Felipe-klz/cr200-explorador/downloads/presupuesto.md

# CR200 · BOM y presupuesto de planificación

Argentina,AMBA. Precios consultados24/10/2026. Revisión geométricaS02-A62bc86d8.

Base con auxilio,desarrollo y contingencia20%:ARS 25.659.730. Escenario bajo:ARS 21.227.311;alto:ARS 38.456.928. No es oferta firme ni autorización de fabricación.

## Detalle

|Código|Concepto|Cantidad|Unitario origen|Subtotal ARS de línea|Estado|
|---|---|---:|---:|---:|---|
|M01|Largueros RHS150×75×5|2 barra 6m|ARS 405,060.00|ARS 810.120|Estimado · a cotizar|
|M02|Travesaños RHS80×40×3|4 barra 6m|ARS 103,599.00|ARS 414.396|Estimado · a cotizar|
|M03|Brazos de lanza RHS150×60×5|1 barra 6m|ARS 376,800.00|ARS 376.800|Estimado · a cotizar|
|M04|Arriostramiento RHS60×40×3|1 barra 6m|ARS 85,000.00|ARS 85.000|Estimado · a cotizar|
|M05|Reacción de estacionamiento RHS40×40×3|1 barra 6m|ARS 65,000.00|ARS 65.000|Estimado · a cotizar|
|M06|Travesaño posterior RHS80×60×3|1 barra 6m|ARS 106,450.50|ARS 106.450|Estimado · a cotizar|
|M07|Chapas mixtas e4/5/6/8/10 · soportes y puentes|123 kg bruto|ARS 3,200.00|ARS 393.600|Estimado · a cotizar|
|M08|Galvanizada2 mm · guardabarros y faldones|1 chapa 1.22×2.44m|ARS 171,026.00|ARS 171.026|Publicado · confirmar anidado|
|M09|Ejes frenados completos · referencia local1000 kg|2 eje|ARS 1,290,000.00|ARS 2.580.000|Publicado · configuración distinta|
|M10|Configuración a medida y verificación de interfaces|1 previsión|ARS 320,000.00|ARS 320.000|Estimado · a cotizar|
|M11|NeumáticoST205/75R15 107N D|4 unidad|USD 186.00|ARS 1.153.200|Publicado · origen exterior|
|M12|Llantas15×5.5,5×114.3 con capacidad certificada|4 unidad|ARS 150,000.00|ARS 600.000|Estimado · a cotizar|
|M13|Paquetes completos doble ojo,1250 lb de referencia|4 paquete|USD 34.18|ARS 211.916|Publicado · referencia compatible a verificar|
|M14|Articulación tándem completa · húmedos y bronce|1 kit|USD 160.00|ARS 248.000|Estimado · a cotizar|
|M15|AbrazaderasU y tuercas/arandelas|8 juegoU+2tuercas|ARS 18,000.00|ARS 144.000|Estimado · a cotizar|
|M16|Asientos de ballesta mecanizados|4 unidad|ARS 20,000.00|ARS 80.000|Estimado · a cotizar|
|M17|Amortiguador283271 con herrajes de espárrago|4 conjunto|USD 65.95|ARS 408.890|Publicado · origen exterior|
|M18|Topes elastoméricos de compresión|4 unidad|ARS 18,000.00|ARS 72.000|Estimado · a cotizar|
|M19|Cabezal50 mm con pestillo y palanca ·614010PL|1 conjunto|AUD 129.00|ARS 138.962|Publicado · interfaz pendiente|
|M20|Cadenas certificadas con grilletes/ganchos|2 conjunto|ARS 65,000.00|ARS 130.000|Estimado · a cotizar|
|M21|Jockey con rueda y abrazadera|1 conjunto|ARS 143,076.00|ARS 143.076|Publicado · montaje a confirmar|
|M22|Estabilizadores de esquina|4 unidad|ARS 164,904.00|ARS 659.616|Publicado · modelo de referencia|
|M23|Fijación de cabezalM12 8.8|4 juego|ARS 5,000.00|ARS 20.000|Estimado · a cotizar|
|M24|Anclajes viviendaM10 con casquillo y contraplaca|10 conjunto|ARS 12,000.00|ARS 120.000|Estimado · a cotizar|
|M25|Estacionamiento: fundas, cables y repartidor|1 kit 4 ruedas|ARS 225,000.00|ARS 225.000|Estimado · a cotizar|
|M26|Controlador de frenos · referencia económica|1 unidad|ARS 420,000.00|ARS 420.000|Publicado · confirmar inclusión|
|M27|Ruptura eléctrica: interruptor, batería y caja|1 kit|ARS 180,000.00|ARS 180.000|Estimado · a cotizar|
|M28|Ópticas traseras LED con reversa|1 par|ARS 37,100.00|ARS 37.100|Publicado · especificación a verificar|
|M29|Marcadores laterales ámbar|6 unidad|ARS 15,000.00|ARS 90.000|Estimado · a cotizar|
|M30|Catadióptricos triangulares rojos|2 unidad|ARS 6,500.00|ARS 13.000|Estimado · a cotizar|
|M31|Portapatente e iluminación blanca|1 conjunto|ARS 30,000.00|ARS 30.000|Estimado · a cotizar|
|M32|Mazo, conectores y protecciones|1 lote|ARS 220,000.00|ARS 220.000|Estimado · a cotizar|
|M33|Presillas aisladas con fijación|11 juego|ARS 3,000.00|ARS 33.000|Estimado · a cotizar|
|M34|Cajas de derivación estancas de frenos|2 unidad|ARS 15,000.00|ARS 30.000|Estimado · a cotizar|
|M35|Tornillería auxiliar no desglosada|1 lote|ARS 85,000.00|ARS 85.000|Estimado · a cotizar|
|C01|AlambreMIG ER70S6|2 rollo 5 kg|ARS 29,267.00|ARS 58.534|Publicado · consumo estimado|
|C02|Gas, abrasivos y consumibles de taller|1 lote|ARS 150,000.00|ARS 150.000|Estimado · a cotizar|
|S01|Plantilla, trazado y preparación|12 hora|ARS 18,000.00|ARS 216.000|Estimado · a cotizar|
|S02|Corte de tubos y perforado|24 hora|ARS 18,000.00|ARS 432.000|Estimado · a cotizar|
|S03|Armado, punteo y soldadura|56 hora|ARS 18,000.00|ARS 1.008.000|Estimado · a cotizar|
|S04|Montaje mecánico de conjuntos|24 hora|ARS 18,000.00|ARS 432.000|Estimado · a cotizar|
|S05|Instalación eléctrica|14 hora|ARS 18,000.00|ARS 252.000|Estimado · a cotizar|
|S06|Reglaje frenos y estacionamiento|12 hora|ARS 18,000.00|ARS 216.000|Estimado · a cotizar|
|S07|Control dimensional y terminación|12 hora|ARS 18,000.00|ARS 216.000|Estimado · a cotizar|
|S08|Corte láser de chapas y preparación|1 lote|ARS 280,000.00|ARS 280.000|Estimado · a cotizar|
|S09|Plegado de puentes y guardabarros|1 lote|ARS 180,000.00|ARS 180.000|Estimado · a cotizar|
|S10|Preparación y sistema epoxi/poliuretano|20 m² estimado|ARS 25,000.00|ARS 500.000|Estimado · a cotizar|
|S11|Protección de cavidades y sellados|1 lote|ARS 80,000.00|ARS 80.000|Estimado · a cotizar|
|S12|Fletes nacionales de materiales y conjuntos|1 previsiónAMBA|ARS 300,000.00|ARS 300.000|Estimado · a cotizar|
|D01|Ingeniería de detalle y cierre de interfaces|60 hora|ARS 35,000.00|ARS 2.100.000|Estimado · a cotizar|
|D02|Inspecciones, pesaje y ensayos de prototipo|1 provisión|ARS 650,000.00|ARS 650.000|Estimado · a cotizar|
|O01|Neumático de auxilioST205/75R15|1 unidad|USD 186.00|ARS 288.300|Publicado · origen exterior|
|O02|Llanta de auxilio15×5.5,5×114.3|1 unidad|ARS 150,000.00|ARS 150.000|Estimado · a cotizar|
|O03|Soporte de auxilio y fijación antiaflojamiento|1 conjunto|ARS 120,000.00|ARS 120.000|Estimado · a cotizar|

Los subtotales de línea no incluyen la previsión adicional de importación ni contingencia. Ambos se agregan una sola vez.

- Líneas directas:ARS 18.443.987.
- Previsión importación:ARS 2.939.122.
- Subtotal:ARS 21.383.109.
- Contingencia20%:ARS 4.276.622.
- Total:ARS 25.659.730.

## Bases de cada línea

- **M01**:2 cortes×4400 mm. Estimación4000 ARS/kg sobre 202.53 kg de stock: medida especial sin precio publicado exacto. Compra barras completas; el sobrante queda en taller. Certificado, tolerancias y espesor real a confirmar.
- **M02**:11 cortes×1850 mm; plan3+3+3+2. Precio proxy de 3.2 mm, no mismo espesor del CAD. Compra barras completas; el sobrante queda en taller. Certificado, tolerancias y espesor real a confirmar.
- **M03**:2 cortes de 2706.67 mm aproximadamente;4000 ARS/kg sobre 94.2 kg de stock. Compra barras completas; el sobrante queda en taller. Certificado, tolerancias y espesor real a confirmar.
- **M04**:1 corte928 mm antes del ajuste de extremos; estimación por sección, no precio directo. Compra barras completas; el sobrante queda en taller. Certificado, tolerancias y espesor real a confirmar.
- **M05**:1 corte1850 mm; estimación por sección. Compra barras completas; el sobrante queda en taller. Certificado, tolerancias y espesor real a confirmar.
- **M06**:1 corte2000 mm; proxy de 3.2 mm. Incluye solo BO-BUMPER; soportes van en chapas. Compra barras completas; el sobrante queda en taller. Certificado, tolerancias y espesor real a confirmar.
- **M07**:63 ítems CAD:90.64 kg geométricos netos×1.35, redondeo a kg.3200 ARS/kg incluye sobreprecio de fraccionado; corte/plegado se cobra en servicios. PuentesC75×40×4 se pliegan de chapa. No es peso de todo el chasis.
- **M08**:4 ítems CAD,21.12 kg geométricos netos; chapa bruta46.74 kg. Anidado/recortes a confirmar antes de corte; radios y desplegados todavía de desarrollo.
- **M09**:Incluye tubo, puntas, mazas/tambores, rodamientos, frenos y espárragos: se paga el conjunto una vez. Referencia4 agujeros distinta del CAD 5×114.3; requiere cotización a medida.
- **M10**:Reserva para trocha/HF2260, centrosSC1925 y patrón5×114.3. No resuelve una incompatibilidad por sí sola; cotizar conjunto completo y reemplazar esta provisión con oferta firme.
- **M11**:Goodyear Endurance como referencia que coincide con medida/índices del CAD. Precio origenEEUU; importación separada.
- **M12**:Estimación local, sin oferta exacta verificada. Confirmar ET, centro, asiento, presión y capacidad; no sustituir por llanta automotor usada sin validar.
- **M13**:BOM de compra:4 paquetes completos. CAD actual:15 hojas representadas y4 pernos centrales; solo delantero izquierdo tiene3 hojas, los otros tres conservan4 pendientes de revisión. No comprar hojas sueltas. Cotejar forma libre/cargada.
- **M14**:EstimaciónUSD160 frente a kit estándarAP233 deUSD75.18. Incluye2 balancines,8 gemelas,14 pernos/tuercas,14 bujes y16 arandelas de empuje representadas. Configuración húmeda/bronce no cotizada; no sumar otro kit ni pernos sueltos.
- **M15**:8 abrazaderas con 16 tuercas/arandelas. Placas de apriete enM07, asientos enM16. Diámetro y kitOEM por cerrar; no fabricar abrazaderas con varilla roscada común.
- **M16**:Componente de compra a especificar paraØ60.325; incluye alojamiento de cabeza central. Material y mecanizado incluidos en esta estimación, no enM07.
- **M17**:4 amortiguadores y4 conjuntos CAD de gomas/arandelas/tuercas en un único costo. Ménsulas propias enM07. Confirmar herrajes incluidos y curva con proveedor.
- **M18**:Solo goma/tope; soporte metálico enM07. Rigidez y altura a especificar.
- **M19**:ReferenciaAUD, palanca incluida. Dibujo de fijaciones de vendedor difiere del CAD: compatibilidad pendiente. No añadir otra palanca.
- **M20**:Previsión por conjunto certificado adecuado a masa remolcada; no inferir capacidad por diámetro del dibujo ni usar mosquetones decorativos.
- **M21**:Referencia1000 lb local; confirmarØ60 y recorrido. Adaptador propio enM07.
- **M22**:Referencia local2000 lb; geometría final a confirmar. Son apoyos de estacionamiento, no reemplazan gatos de servicio ni elevan vehículo ocupado.
- **M23**:Cada juego: bulón, tuerca y arandelas. Largo y cantidad final dependen de cabezal seleccionado.
- **M24**:Kit completo listo para instalar: bulón8.8, casquillo, contraplaca e interfaz EPDM. OrejasFR-BODYTAB enM07; no incluye piso ni vivienda.
- **M25**:Previsión basada en kit publicado225000. Confirmar versión4 ruedas y terminales compatibles. Palanca ya incluida enM19; esta línea no agrega otra palanca al CAD.
- **M26**:No representado como pieza del chasis. La página de eje es contradictoria: presupuesto conservador separado. Si cotización confirma incluido, poner0 aquí. Confirmar respuesta de control y capacidad4 frenos. Cableado básico previsto enM32/S05; interfaces electrónicas especiales del tractor a cotizar.
- **M27**:Batería dedicada12V de capacidad por validar, interruptor/cable, caja estanca, fusible y cargador. No sustituye estacionamiento mecánico; confirmar duración de frenado.
- **M28**:2 unidades por juego; no multiplicar otra vez por 2. Marcado y distribución fotométrica a verificar.
- **M29**:Precio estimado por referencia lateral; seleccionar ámbar y soportes adecuados.
- **M30**:Confirmar aprobación de producto, dimensiones y montaje.
- **M31**:Incluye soporte y luz; patente/trámite no incluidos.
- **M32**:Previsión:8m de cable7×1.5,20m de ramal2×2.5, corrugado, terminales sellados, fusibles y conector al tractor. Secciones/longitudes son previsiones de compra; cálculo de caída de tensión pendiente.
- **M33**:11 posiciones CAD; cada juego incluye presilla y tornillo. Separado del cableadoM32.
- **M34**:Caja, prensaestopas y borneras incluidos.
- **M35**:M8/M10 de ménsulas, fijaciones de ópticas, terminales mecánicos y remaches. Excluye kits ya contados enM15, M17, M23, M24, M33.
- **C01**:Compra10 kg. Los11 ítemsCAD de cordones se cubren aquí; consumo real por WPS y cordones totales, no solo los dibujados.
- **C02**:Previsión gas protector, discos corte/desbaste, brocas y limpieza. No incluye pintura ni alambreMIG ni mano de obra.
- **S01**:Tarifa de taller supuesta18000 ARS/h, costo final de planificación con herramientas/energía/gastos generales. No es salarioUOM ni oferta recibida. Excluye materiales, subcontratos y consumibles explícitos.
- **S02**:Tarifa de taller supuesta18000 ARS/h, costo final de planificación con herramientas/energía/gastos generales. No es salarioUOM ni oferta recibida. Excluye materiales, subcontratos y consumibles explícitos.
- **S03**:Tarifa de taller supuesta18000 ARS/h, costo final de planificación con herramientas/energía/gastos generales. No es salarioUOM ni oferta recibida. Excluye materiales, subcontratos y consumibles explícitos.
- **S04**:Tarifa de taller supuesta18000 ARS/h, costo final de planificación con herramientas/energía/gastos generales. No es salarioUOM ni oferta recibida. Excluye materiales, subcontratos y consumibles explícitos.
- **S05**:Tarifa de taller supuesta18000 ARS/h, costo final de planificación con herramientas/energía/gastos generales. No es salarioUOM ni oferta recibida. Excluye materiales, subcontratos y consumibles explícitos.
- **S06**:Tarifa de taller supuesta18000 ARS/h, costo final de planificación con herramientas/energía/gastos generales. No es salarioUOM ni oferta recibida. Excluye materiales, subcontratos y consumibles explícitos.
- **S07**:Tarifa de taller supuesta18000 ARS/h, costo final de planificación con herramientas/energía/gastos generales. No es salarioUOM ni oferta recibida. Excluye materiales, subcontratos y consumibles explícitos.
- **S08**:Subcontrato supuesto para el lote M07/M08; material ya contado. No duplica horas de corte de tubosS02.
- **S09**:Previsión18 operaciones×10000 ARS. Desarrollos, radios y cantidad final por taller; material ya contado.
- **S10**:Previsión de superficie exterior, no superficie total BREP que incluye interiores. Precio supuesto de servicio terminado con preparación/pinturas. No galvanizado en caliente; guardabarros galvanizados separados.
- **S11**:Aplicación de cera compatible y sellados locales; accesos y drenajes a definir. No asumir pintura interior integral de RHS.
- **S12**:Taller y compras enAMBA, sin destino exacto. Incluye barras6m; no importaciones, que se calculan aparte. Fuera deAMBA recotizar.
- **D01**:Previsión de revisión estructural/uniones, selecciónOEM y corrección de interferencias. No es trabajo ya ejecutado ni certificado de aptitud.
- **D02**:Reserva para pesaje por rueda/enganche, inspección de soldaduras y pruebas de frenado. Protocolo/laboratorio por definir; no incluye aranceles oficiales ni garantiza aprobación.
- **O01**:Adicional de compra no modelado; debe igualar selección final de rodado.
- **O02**:Adicional no modelado; capacidad/ET/presión a confirmar.
- **O03**:Provisión de soporte no diseñado enCAD; comprobar anclaje, acceso y masas antes de incorporar.

## Método y límites

- Cada elemento CAD se asigna una sola vez a una línea de compra o consumible. Un conjunto comercial se paga una sola vez.
- Tubos por barras completas de 6m, plan preliminar de cortes sin crédito por sobrantes. Las longitudes nominales no son lista liberada a taller.
- Chapas mixtas por masa nominal BREP×7850 kg/m³,35% de merma y redondeo a kg; compra fraccionada supuesta, corte/plegado separados. No suma hojas completas de todos los espesores.
- No se calcula peso certificado del vehículo a partir de envolventes comerciales. Volúmenes CAD solo se usan para acero propio identificado.
- 154 horas de taller×18000 ARS/h;60 horas de ingeniería×35000 ARS/h. Estimaciones propias, no salarios ni presupuestos de proveedores.
- Precios locales: valor de pantalla en un pago, sin descuentos condicionales. No se vuelve a sumar 21% a todos los precios. IVA no desglosado o certificado por vendedor queda por confirmar. Estimaciones propias se tratan como costos finales de caja supuestos.
- Importados: precio de origen convertido con referencias BNA. Previsión adicional 120% del valor convertido para flete internacional, seguro, tributos y gestión; no es alícuota aduanera ni cotización de importación. Escenarios usan 70%/190%; no implican que puedan importarse por courier.
- Contingencia 20% del subtotal, incluida previsión de importación y desarrollo si se selecciona. No es ingreso ni costo fijo comprometido.
- Rango bajo/alto construido por factores de cada línea y logística; sin probabilidad estadística. No reemplaza cotización formal.
- Precios sirven para planificar una unidad; diseño S02-A conserva 10 interferencias externas y no está liberado para comprar/fabricar/circular.

## Fuera del total

- Vivienda, piso estructural, muebles, agua/gas, instalaciones habitables y paneles solares.
- Vehículo tractor, enganche estructural específico del tractor, seguro y combustible. El controlador electrónico sí está previsto.
- Aranceles oficiales, patentamiento, inspección reglamentaria y homologación: sin tarifa verificada, a cotizar; no integran el total.
- Cambios mayores de diseño, repetición de prototipos, financiación y variación de precios posterior a la fecha de consulta.

## Fuentes

- BNA · [BNA · cotización del23/10/2026](https://www.bna.com.ar/Personas/) · Sin precio unitario ARS. USD billete venta1550 ARS; AUD divisa venta1077.2269 ARS. Referencias para conversión, no costo efectivo de liquidación.
- T80 · [Gramabi · RHS80×40×3.2, barra 6m](https://gramabi.com/productos/cano-estructural-rectangular-de-80-x-40-x-320-mm-gramabi-barra-de-6-mt-de-largo-tubo-80x40x325-medidas-hierro-80x40/) · 103599 ARS. Lectura directa103599; resultado de búsqueda anterior101499 descartado. Espesor3.2 distinto de 3.0 del CAD; no autoriza sustitución.
- T8060 · [Alumetal · RHS80×60×3.2, barra 6m](https://alumetalsa.com.ar/presupuestador/categoria-producto/canos-rectangulares/) · 106450.5 ARS. Referencia dimensional cercana; CAD 80×60×3.0.
- PLATE · [Cormetal · chapaLAC1/4 in,1.5×3m](https://www.cormetal.com.ar/materiales-tiendacotizacion/rubro/8/materiales) · 509008.93 ARS. Masa teórica224.314 kg con 6.35 mm y7850 kg/m³:2269.17 ARS/kg. Base para estimar cortes en espesores4–10 mm; confirmar IVA y certificado.
- GALV · [INNOA · chapa galvanizada2 mm,1.22×2.44m](https://innoa.com.ar/categorias/pantografia/chapa-galvanizada/) · 171026 ARS. Compra1 chapa completa; comprobar anidado de guardabarros/faldones.
- AXLE · [Motus · eje completo frenado1000 kg](https://motustrailer.com.ar/product/eje-completo-con-frenos-electricos/) · 1290000 ARS. Referencia local. Página publica4×98/4×100; CAD 5×114.3. Hay texto contradictorio sobre controlador incluido; se presupuesta aparte hasta cotización escrita. No es oferta compatible confirmada.
- CONTROL · [Motus · módulo controlador económico](https://motustrailer.com.ar/tienda-motus/) · 420000 ARS. Confirmar4 frenos y compatibilidad con vehículo tractor.
- PARK · [Motus · kit estacionamiento con cable de emergencia](https://motustrailer.com.ar/product/kit-de-freno-de-mano-para-trailers-con-cable-de-emergencia/) · 225000 ARS. Referencia de costo. Cotizar versión para cuatro ruedas; palanca propia del cabezal se conserva, no se cobra otra palanca CAD.
- SPRING · [Trailerparts · UNA219, referencia 072-022-00](https://trailerparts.com/3-leaf-1-250-lb-capacity-25-1-4-double-eye-trailer-leaf-spring-similar-to-una219-dexter-072-022-00.html) · 34.18 USD. Oferta compatible declarada por vendedor; cotejar longitudes libre/cargada y proveedor antes de comprar. Precio por paquete, no por hoja.
- ARTIC · [etrailer · AP233](https://www.etrailer.com/trailer-suspension/redline/ap233.html) · 75.18 USD. Kit estándar como referencia. CAD usa pernos húmedos/bronce; se prevéUSD160 por un conjunto completo compatible, pendiente cotización. No sumar kitAP233 y pernos otra vez.
- SHOCK · [Lippert · shock283271](https://www.lippert.com/towing-trailering/wheel-axle/suspension-parts/shocks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) · 65.95 USD. Precio publicado en catálogo indexado del fabricante. Ficha de producto sin precio extraíble; contrastado con SouthwestWheel62.99 USD. Herrajes de goma/arandelas/tuercas incluidos en el costo del conjunto.
- SHOCK2 · [SouthwestWheel · shock283271](https://www.southwestwheel.com/p-12330-lippert-standard-replacement-shock-black-283271.aspx) · 62.99 USD. Comparación comercial, sin aplicar descuentos por volumen.
- COUPLING · [Brisbane AL-KO ·614010PL](https://www.brisbanealko.com.au/products/al-ko-3500kg-50mm-fixed-coupling-with-brake-lever) · 129 AUD. Incluye palanca. La ficha comercial describe3 fijaciones y el CAD 4: compatibilidad pendiente, usar como referencia de costo; no orden de compra.
- TIRE · [Discount Tire · Goodyear EnduranceST205/75R15 107N D](https://www.discounttire.com/buy-tires/goodyear-endurance/p/32602) · 186 USD. Precio origenEEUU, no incluye importación ni servicios disponibles solo enEEUU.
- JOCKEY · [Amato · timonera1000 lb](https://www.amato.com.ar/productos/rueda-timonera-reforzada-rebatible-y-regulable-para-trailer/) · 143076 ARS. Referencia local; confirmar tuboØ60, altura y montaje del CAD.
- STEADY · [Amato · pata2000 lb](https://www.amato.com.ar/productos/pata-estabilizadora-trailer-con-gato-y-manivela-2000lbs/) · 164904 ARS. Lectura directa164904; búsqueda177173 descartada. Referencia de capacidad/mecanismo, no geometría idéntica confirmada.
- LIGHT · [InnovaLED · juego2 faros con reversa](https://www.innovaled.ar/productos-iluminacion-vehicular/faros-led) · 37100 ARS. Precio de lista en un pago; no aplicar descuento de transferencia. Confirmar marcado y funciones.
- WIRE · [DEM-BER · ER70S6 0.8 mm,5 kg](https://dember.com.ar/producto/alambre-para-soldar-mig-er70s-6-0-8mm-rollo-5kg/) · 29267 ARS. Precio de lista, sin descuento de transferencia.
- LOCAL-LIGHT · [TD Repuestos · faros laterales](https://tdrepuestos.com.ar/tienda/3/) · 12215 ARS. Producto1033e rojo como referencia económica; ámbar y montaje del CAD requieren otra selección.
- EST · [Estimación propia de planificación]() · Sin precio unitario ARS. No cotización: valores finales de caja supuestos para AMBA, una unidad prototipo. Servicios por horas, cantidades y consumibles indicados. Rangos de escenario explícitos; no intervalos estadísticos.
