Felipe-klz/cr200-explorador/assets/overview.png

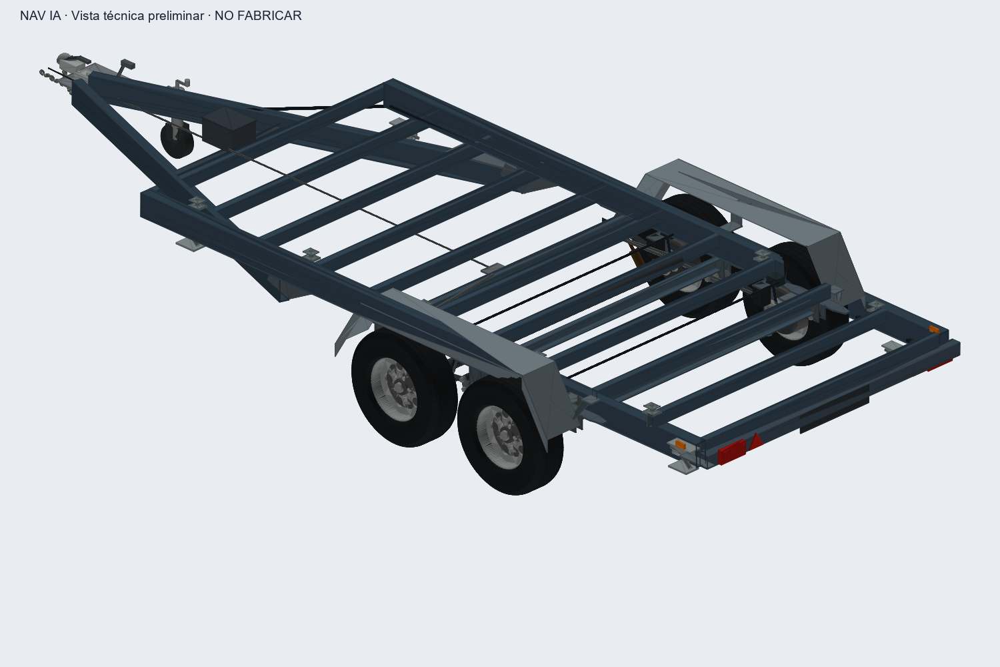
assets/overview.png
