Felipe-klz/cr200-explorador/assets/s02a-detalle.png

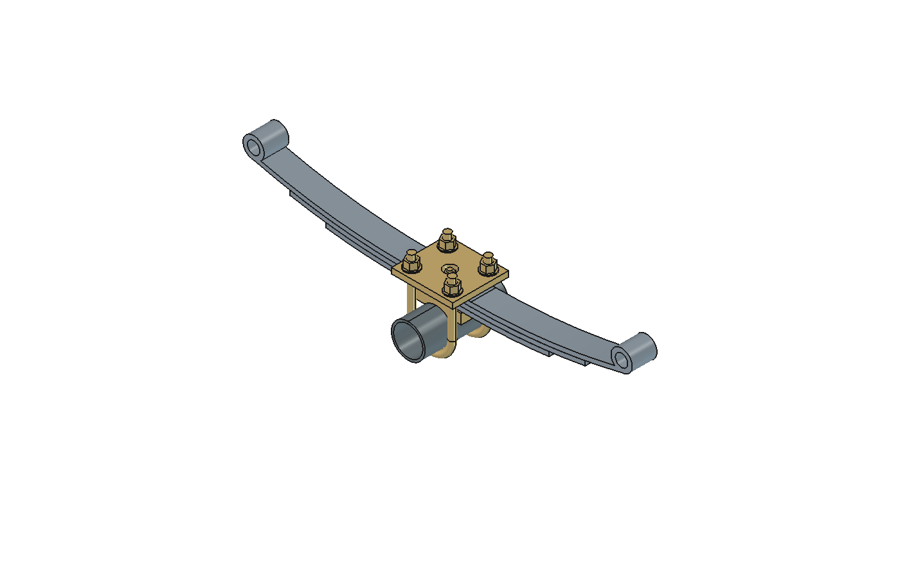
assets/s02a-detalle.png
