Felipe-klz/cr200-explorador/assets/suspension.png

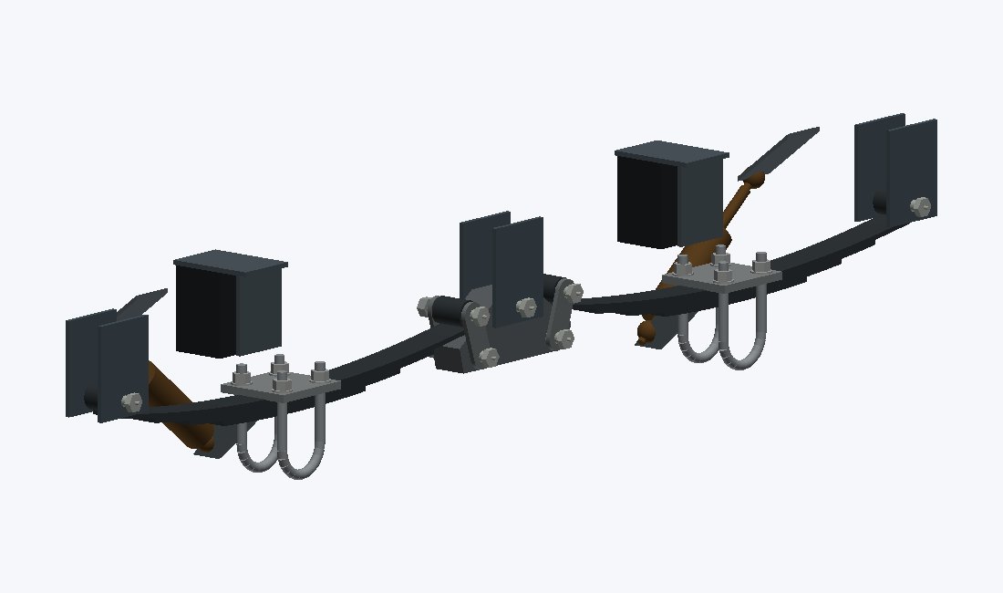
assets/suspension.png
