Felipe-klz/cr200-explorador/downloads/bom-335-elementos.csv

ID CAD | Descripción | Grupo | Cantidad CAD | Línea de costo | Material | Volumen nominal mm3 | Dimensiones envolvente mm | Criterio de precio
FR-LONG-I | Larguero principal RHS150×75×5 | FRAME | 1 | M01 | Tubo estructural soldable certificado IRAM-IAS U500-2592; fy de cálculo mínimo235 MPa, E200 GPa; espesor nominal sujeto a tolerancia y certificado. | 9460000.0 | 4400.00×75.00×150.00 | Incluido en la línea de compra M01; no sumar precio por cada sólido.
FR-DOUBLER--1-0 | Placa de reparto e6 con extremos achaflanados | FRAME | 1 | M07 | Chapa S235 o equivalente certificado, e6 mm. | 205800.0 | 500.00×75.00×6.00 | Incluido en la línea de compra M07; no sumar precio por cada sólido.
FR-DOUBLER--1-1 | Placa de reparto e6 con extremos achaflanados | FRAME | 1 | M07 | Chapa S235 o equivalente certificado, e6 mm. | 205800.0 | 500.00×75.00×6.00 | Incluido en la línea de compra M07; no sumar precio por cada sólido.
FR-DOUBLER--1-2 | Placa de reparto e6 con extremos achaflanados | FRAME | 1 | M07 | Chapa S235 o equivalente certificado, e6 mm. | 205800.0 | 500.00×75.00×6.00 | Incluido en la línea de compra M07; no sumar precio por cada sólido.
FR-LONG-D | Larguero principal RHS150×75×5 | FRAME | 1 | M01 | Tubo estructural soldable certificado IRAM-IAS U500-2592; fy de cálculo mínimo235 MPa, E200 GPa; espesor nominal sujeto a tolerancia y certificado. | 9460000.0 | 4400.00×75.00×150.00 | Incluido en la línea de compra M01; no sumar precio por cada sólido.
FR-DOUBLER-1-0 | Placa de reparto e6 con extremos achaflanados | FRAME | 1 | M07 | Chapa S235 o equivalente certificado, e6 mm. | 205800.0 | 500.00×75.00×6.00 | Incluido en la línea de compra M07; no sumar precio por cada sólido.
FR-DOUBLER-1-1 | Placa de reparto e6 con extremos achaflanados | FRAME | 1 | M07 | Chapa S235 o equivalente certificado, e6 mm. | 205800.0 | 500.00×75.00×6.00 | Incluido en la línea de compra M07; no sumar precio por cada sólido.
FR-DOUBLER-1-2 | Placa de reparto e6 con extremos achaflanados | FRAME | 1 | M07 | Chapa S235 o equivalente certificado, e6 mm. | 205800.0 | 500.00×75.00×6.00 | Incluido en la línea de compra M07; no sumar precio por cada sólido.
FR-CROSS-01 | Travesaño de piso80×40×3 · estación20 | FRAME | 1 | M02 | Tubo estructural soldable certificado IRAM-IAS U500-2592; fy de cálculo mínimo235 MPa, E200 GPa; espesor nominal sujeto a tolerancia y certificado. | 1265400.0 | 40.00×1850.00×80.00 | Incluido en la línea de compra M02; no sumar precio por cada sólido.
FR-WELD-0 | Cordones de unión travesaño1 | FRAME | 1 | C01 | Metal de aporte compatible con acero certificado; proceso GMAW/MAG propuesto. | 720.0 | 3.00×1850.00×80.00 | Incluido en la línea de compra C01; no sumar precio por cada sólido.
FR-CROSS-02 | Travesaño de piso80×40×3 · estación440 | FRAME | 1 | M02 | Tubo estructural soldable certificado IRAM-IAS U500-2592; fy de cálculo mínimo235 MPa, E200 GPa; espesor nominal sujeto a tolerancia y certificado. | 1265400.0 | 40.00×1850.00×80.00 | Incluido en la línea de compra M02; no sumar precio por cada sólido.
FR-WELD-1 | Cordones de unión travesaño2 | FRAME | 1 | C01 | Metal de aporte compatible con acero certificado; proceso GMAW/MAG propuesto. | 720.0 | 3.00×1850.00×80.00 | Incluido en la línea de compra C01; no sumar precio por cada sólido.
FR-CROSS-03 | Travesaño de piso80×40×3 · estación880 | FRAME | 1 | M02 | Tubo estructural soldable certificado IRAM-IAS U500-2592; fy de cálculo mínimo235 MPa, E200 GPa; espesor nominal sujeto a tolerancia y certificado. | 1265400.0 | 40.00×1850.00×80.00 | Incluido en la línea de compra M02; no sumar precio por cada sólido.
FR-WELD-2 | Cordones de unión travesaño3 | FRAME | 1 | C01 | Metal de aporte compatible con acero certificado; proceso GMAW/MAG propuesto. | 720.0 | 3.00×1850.00×80.00 | Incluido en la línea de compra C01; no sumar precio por cada sólido.
FR-CROSS-04 | Travesaño de piso80×40×3 · estación1320 | FRAME | 1 | M02 | Tubo estructural soldable certificado IRAM-IAS U500-2592; fy de cálculo mínimo235 MPa, E200 GPa; espesor nominal sujeto a tolerancia y certificado. | 1265400.0 | 40.00×1850.00×80.00 | Incluido en la línea de compra M02; no sumar precio por cada sólido.
FR-WELD-3 | Cordones de unión travesaño4 | FRAME | 1 | C01 | Metal de aporte compatible con acero certificado; proceso GMAW/MAG propuesto. | 720.0 | 3.00×1850.00×80.00 | Incluido en la línea de compra C01; no sumar precio por cada sólido.
FR-CROSS-05 | Travesaño de piso80×40×3 · estación1760 | FRAME | 1 | M02 | Tubo estructural soldable certificado IRAM-IAS U500-2592; fy de cálculo mínimo235 MPa, E200 GPa; espesor nominal sujeto a tolerancia y certificado. | 1265400.0 | 40.00×1850.00×80.00 | Incluido en la línea de compra M02; no sumar precio por cada sólido.
FR-WELD-4 | Cordones de unión travesaño5 | FRAME | 1 | C01 | Metal de aporte compatible con acero certificado; proceso GMAW/MAG propuesto. | 720.0 | 3.00×1850.00×80.00 | Incluido en la línea de compra C01; no sumar precio por cada sólido.
FR-CROSS-06 | Travesaño de piso80×40×3 · estación2200 | FRAME | 1 | M02 | Tubo estructural soldable certificado IRAM-IAS U500-2592; fy de cálculo mínimo235 MPa, E200 GPa; espesor nominal sujeto a tolerancia y certificado. | 1265400.0 | 40.00×1850.00×80.00 | Incluido en la línea de compra M02; no sumar precio por cada sólido.
FR-WELD-5 | Cordones de unión travesaño6 | FRAME | 1 | C01 | Metal de aporte compatible con acero certificado; proceso GMAW/MAG propuesto. | 720.0 | 3.00×1850.00×80.00 | Incluido en la línea de compra C01; no sumar precio por cada sólido.
FR-CROSS-07 | Travesaño de piso80×40×3 · estación2640 | FRAME | 1 | M02 | Tubo estructural soldable certificado IRAM-IAS U500-2592; fy de cálculo mínimo235 MPa, E200 GPa; espesor nominal sujeto a tolerancia y certificado. | 1265400.0 | 40.00×1850.00×80.00 | Incluido en la línea de compra M02; no sumar precio por cada sólido.
FR-WELD-6 | Cordones de unión travesaño7 | FRAME | 1 | C01 | Metal de aporte compatible con acero certificado; proceso GMAW/MAG propuesto. | 720.0 | 3.00×1850.00×80.00 | Incluido en la línea de compra C01; no sumar precio por cada sólido.
FR-CROSS-08 | Travesaño de piso80×40×3 · estación3080 | FRAME | 1 | M02 | Tubo estructural soldable certificado IRAM-IAS U500-2592; fy de cálculo mínimo235 MPa, E200 GPa; espesor nominal sujeto a tolerancia y certificado. | 1265400.0 | 40.00×1850.00×80.00 | Incluido en la línea de compra M02; no sumar precio por cada sólido.
FR-WELD-7 | Cordones de unión travesaño8 | FRAME | 1 | C01 | Metal de aporte compatible con acero certificado; proceso GMAW/MAG propuesto. | 720.0 | 3.00×1850.00×80.00 | Incluido en la línea de compra C01; no sumar precio por cada sólido.
FR-CROSS-09 | Travesaño de piso80×40×3 · estación3520 | FRAME | 1 | M02 | Tubo estructural soldable certificado IRAM-IAS U500-2592; fy de cálculo mínimo235 MPa, E200 GPa; espesor nominal sujeto a tolerancia y certificado. | 1265400.0 | 40.00×1850.00×80.00 | Incluido en la línea de compra M02; no sumar precio por cada sólido.
FR-WELD-8 | Cordones de unión travesaño9 | FRAME | 1 | C01 | Metal de aporte compatible con acero certificado; proceso GMAW/MAG propuesto. | 720.0 | 3.00×1850.00×80.00 | Incluido en la línea de compra C01; no sumar precio por cada sólido.
FR-CROSS-10 | Travesaño de piso80×40×3 · estación3960 | FRAME | 1 | M02 | Tubo estructural soldable certificado IRAM-IAS U500-2592; fy de cálculo mínimo235 MPa, E200 GPa; espesor nominal sujeto a tolerancia y certificado. | 1265400.0 | 40.00×1850.00×80.00 | Incluido en la línea de compra M02; no sumar precio por cada sólido.
FR-WELD-9 | Cordones de unión travesaño10 | FRAME | 1 | C01 | Metal de aporte compatible con acero certificado; proceso GMAW/MAG propuesto. | 720.0 | 3.00×1850.00×80.00 | Incluido en la línea de compra C01; no sumar precio por cada sólido.
FR-CROSS-11 | Travesaño de piso80×40×3 · estación4380 | FRAME | 1 | M02 | Tubo estructural soldable certificado IRAM-IAS U500-2592; fy de cálculo mínimo235 MPa, E200 GPa; espesor nominal sujeto a tolerancia y certificado. | 1265400.0 | 40.00×1850.00×80.00 | Incluido en la línea de compra M02; no sumar precio por cada sólido.
FR-WELD-10 | Cordones de unión travesaño11 | FRAME | 1 | C01 | Metal de aporte compatible con acero certificado; proceso GMAW/MAG propuesto. | 720.0 | 3.00×1850.00×80.00 | Incluido en la línea de compra C01; no sumar precio por cada sólido.
FR-BRACE--1-0 | Cartela interior triangular del nudo de colgante | FRAME | 1 | M07 | Acero S235,6 mm de placa en solución final; el CAD muestra envolvente de refuerzo, no despiece definitivo. | 16800.0 | 6.00×80.00×70.00 | Incluido en la línea de compra M07; no sumar precio por cada sólido.
FR-BRACE--1-1 | Cartela interior triangular del nudo de colgante | FRAME | 1 | M07 | Acero S235,6 mm de placa en solución final; el CAD muestra envolvente de refuerzo, no despiece definitivo. | 16800.0 | 6.00×80.00×70.00 | Incluido en la línea de compra M07; no sumar precio por cada sólido.
FR-BRACE-1-0 | Cartela interior triangular del nudo de colgante | FRAME | 1 | M07 | Acero S235,6 mm de placa en solución final; el CAD muestra envolvente de refuerzo, no despiece definitivo. | 16800.0 | 6.00×80.00×70.00 | Incluido en la línea de compra M07; no sumar precio por cada sólido.
FR-BRACE-1-1 | Cartela interior triangular del nudo de colgante | FRAME | 1 | M07 | Acero S235,6 mm de placa en solución final; el CAD muestra envolvente de refuerzo, no despiece definitivo. | 16800.0 | 6.00×80.00×70.00 | Incluido en la línea de compra M07; no sumar precio por cada sólido.
FR-BODYTAB-0 | Oreja perforada de anclaje de vivienda M10 | FRAME | 1 | M07 | S235 e6; tornillo M10 clase8.8 con arandela amplia e interfaz elastomérica3 mm. | 33029.801 | 80.00×70.00×6.00 | Incluido en la línea de compra M07; no sumar precio por cada sólido.
FR-BODYTAB-1 | Oreja perforada de anclaje de vivienda M10 | FRAME | 1 | M07 | S235 e6; tornillo M10 clase8.8 con arandela amplia e interfaz elastomérica3 mm. | 33029.801 | 80.00×70.00×6.00 | Incluido en la línea de compra M07; no sumar precio por cada sólido.
FR-BODYTAB-2 | Oreja perforada de anclaje de vivienda M10 | FRAME | 1 | M07 | S235 e6; tornillo M10 clase8.8 con arandela amplia e interfaz elastomérica3 mm. | 33029.801 | 80.00×70.00×6.00 | Incluido en la línea de compra M07; no sumar precio por cada sólido.
FR-BODYTAB-3 | Oreja perforada de anclaje de vivienda M10 | FRAME | 1 | M07 | S235 e6; tornillo M10 clase8.8 con arandela amplia e interfaz elastomérica3 mm. | 33029.801 | 80.00×70.00×6.00 | Incluido en la línea de compra M07; no sumar precio por cada sólido.
FR-BODYTAB-4 | Oreja perforada de anclaje de vivienda M10 | FRAME | 1 | M07 | S235 e6; tornillo M10 clase8.8 con arandela amplia e interfaz elastomérica3 mm. | 33029.801 | 80.00×70.00×6.00 | Incluido en la línea de compra M07; no sumar precio por cada sólido.
FR-BODYTAB-5 | Oreja perforada de anclaje de vivienda M10 | FRAME | 1 | M07 | S235 e6; tornillo M10 clase8.8 con arandela amplia e interfaz elastomérica3 mm. | 33029.801 | 80.00×70.00×6.00 | Incluido en la línea de compra M07; no sumar precio por cada sólido.
FR-BODYTAB-6 | Oreja perforada de anclaje de vivienda M10 | FRAME | 1 | M07 | S235 e6; tornillo M10 clase8.8 con arandela amplia e interfaz elastomérica3 mm. | 33029.801 | 80.00×70.00×6.00 | Incluido en la línea de compra M07; no sumar precio por cada sólido.
FR-BODYTAB-7 | Oreja perforada de anclaje de vivienda M10 | FRAME | 1 | M07 | S235 e6; tornillo M10 clase8.8 con arandela amplia e interfaz elastomérica3 mm. | 33029.801 | 80.00×70.00×6.00 | Incluido en la línea de compra M07; no sumar precio por cada sólido.
FR-BODYTAB-8 | Oreja perforada de anclaje de vivienda M10 | FRAME | 1 | M07 | S235 e6; tornillo M10 clase8.8 con arandela amplia e interfaz elastomérica3 mm. | 33029.801 | 80.00×70.00×6.00 | Incluido en la línea de compra M07; no sumar precio por cada sólido.
FR-BODYTAB-9 | Oreja perforada de anclaje de vivienda M10 | FRAME | 1 | M07 | S235 e6; tornillo M10 clase8.8 con arandela amplia e interfaz elastomérica3 mm. | 33029.801 | 80.00×70.00×6.00 | Incluido en la línea de compra M07; no sumar precio por cada sólido.
SU-HANGER--1-0 | Soporte fijo de ojo extremo, doble cizalla | SUSP | 1 | M07 | ChapaS235 e6, dos orejas paralelas; distancial libre45.45 mm de proyecto. | 128032.341 | 90.00×57.45×120.38 | Incluido en la línea de compra M07; no sumar precio por cada sólido.
SU-PIN--1-0 | Pivote de ojo fijo · perno húmedo9/16 | SUSP | 1 | M14 | Perno comercial de suspensión tratado;9/16 in, grado, hombro y longitud OEM a confirmar. | 15654.891 | 25.40×90.00×22.00 | Incluido en la línea de compra M14; no sumar precio por cada sólido.
SU-PIN--1-0-NUT | Tuerca autofrenante de perno9/16 | SUSP | 1 | M14 | Acero y sistema de autofrenado de kit; representación sin hélice. | 3285.318 | 25.40×12.00×22.00 | Incluido en la línea de compra M14; no sumar precio por cada sólido.
SU-HANGER--1-1 | Soporte central de balancín, doble cizalla | SUSP | 1 | M07 | ChapaS235 e6, dos orejas paralelas; distancial libre45.45 mm de proyecto. | 131938.44 | 90.00×57.45×124.00 | Incluido en la línea de compra M07; no sumar precio por cada sólido.
SU-PIN--1-1 | Pivote central de balancín · perno húmedo9/16 | SUSP | 1 | M14 | Perno comercial de suspensión tratado;9/16 in, grado, hombro y longitud OEM a confirmar. | 15654.891 | 25.40×90.00×22.00 | Incluido en la línea de compra M14; no sumar precio por cada sólido.
SU-PIN--1-1-NUT | Tuerca autofrenante de perno9/16 | SUSP | 1 | M14 | Acero y sistema de autofrenado de kit; representación sin hélice. | 3285.318 | 25.40×12.00×22.00 | Incluido en la línea de compra M14; no sumar precio por cada sólido.
SU-HANGER--1-2 | Soporte fijo de ojo extremo, doble cizalla | SUSP | 1 | M07 | ChapaS235 e6, dos orejas paralelas; distancial libre45.45 mm de proyecto. | 128032.341 | 90.00×57.45×120.38 | Incluido en la línea de compra M07; no sumar precio por cada sólido.
SU-PIN--1-2 | Pivote de ojo fijo · perno húmedo9/16 | SUSP | 1 | M14 | Perno comercial de suspensión tratado;9/16 in, grado, hombro y longitud OEM a confirmar. | 15654.891 | 25.40×90.00×22.00 | Incluido en la línea de compra M14; no sumar precio por cada sólido.
SU-PIN--1-2-NUT | Tuerca autofrenante de perno9/16 | SUSP | 1 | M14 | Acero y sistema de autofrenado de kit; representación sin hélice. | 3285.318 | 25.40×12.00×22.00 | Incluido en la línea de compra M14; no sumar precio por cada sólido.
SU-EQUALIZER--1 | Balancín compensador142.875×50.8 · referencia013-104-02 | SUSP | 1 | M14 | Componente fundido/comercial de suspensión; materialOEM y capacidad por confirmar. | 577084.265 | 212.00×44.45×88.00 | Incluido en la línea de compra M14; no sumar precio por cada sólido.
SU-EQBUSH--1-0 | Buje de balancín bronceØ22.2/14.3×44.45 | SUSP | 1 | M14 | Bronce de kit engrasable, compatibilidad con fundición y perno por confirmar. | 10066.572 | 22.19×44.45×22.17 | Incluido en la línea de compra M14; no sumar precio por cada sólido.
SU-EQBUSH--1-1 | Buje de balancín bronceØ22.2/14.3×44.45 | SUSP | 1 | M14 | Bronce de kit engrasable, compatibilidad con fundición y perno por confirmar. | 10066.572 | 22.19×44.45×22.17 | Incluido en la línea de compra M14; no sumar precio por cada sólido.
SU-EQBUSH--1-2 | Buje de balancín bronceØ22.2/14.3×44.45 | SUSP | 1 | M14 | Bronce de kit engrasable, compatibilidad con fundición y perno por confirmar. | 10066.572 | 22.19×44.45×22.17 | Incluido en la línea de compra M14; no sumar precio por cada sólido.
SU-LEAF--1-0-0 | Hoja 1/3 · paquete delantero izquierdo · S02-A | SUSP | 1 | M13 | Acero para resortes y tratamiento térmico según fabricante; noS235 ni caño estructural. | 294685.342 | 698.24×44.45×71.47 | Incluido en la línea de compra M13; no sumar precio por cada sólido.
SU-LEAF--1-0-1 | Hoja 2/3 · paquete delantero izquierdo · S02-A | SUSP | 1 | M13 | Acero para resortes y tratamiento térmico según fabricante; noS235 ni caño estructural. | 187042.634 | 530.00×44.45×27.16 | Incluido en la línea de compra M13; no sumar precio por cada sólido.
SU-LEAF--1-0-2 | Hoja 3/3 · paquete delantero izquierdo · S02-A | SUSP | 1 | M13 | Acero para resortes y tratamiento térmico según fabricante; noS235 ni caño estructural. | 141053.479 | 400.00×44.45×16.91 | Incluido en la línea de compra M13; no sumar precio por cada sólido.
SU-BUSH--1-0-0 | Buje de ojo de elástico | SUSP | 1 | M14 | Bronce engrasable o buje especificado por proveedor; versión final única por kit. | 10066.572 | 22.19×44.45×22.17 | Incluido en la línea de compra M14; no sumar precio por cada sólido.
SU-BUSH--1-0-1 | Buje de ojo de elástico | SUSP | 1 | M14 | Bronce engrasable o buje especificado por proveedor; versión final única por kit. | 10066.572 | 22.19×44.45×22.17 | Incluido en la línea de compra M14; no sumar precio por cada sólido.
SU-SHACKLE--1-0--1 | Gemela articulada57.15 mm entre centros | SUSP | 1 | M14 | Gemela comercial de acero de kit,6 mm de espesor representado; no acero de resorte. | 13816.727 | 49.46×6.00×86.38 | Incluido en la línea de compra M14; no sumar precio por cada sólido.
SU-SHACKLE--1-0-1 | Gemela articulada57.15 mm entre centros | SUSP | 1 | M14 | Gemela comercial de acero de kit,6 mm de espesor representado; no acero de resorte. | 13816.727 | 49.46×6.00×86.38 | Incluido en la línea de compra M14; no sumar precio por cada sólido.
SU-INNERPIN--1-0 | Pivote de ojo interior · perno húmedo9/16 | SUSP | 1 | M14 | Perno comercial de suspensión tratado;9/16 in, grado, hombro y longitud OEM a confirmar. | 15654.891 | 25.40×90.00×22.00 | Incluido en la línea de compra M14; no sumar precio por cada sólido.
SU-INNERPIN--1-0-NUT | Tuerca autofrenante de perno9/16 | SUSP | 1 | M14 | Acero y sistema de autofrenado de kit; representación sin hélice. | 3285.318 | 25.40×12.00×22.00 | Incluido en la línea de compra M14; no sumar precio por cada sólido.
SU-EQENDPIN--1-0 | Pivote lateral de balancín · perno húmedo9/16 | SUSP | 1 | M14 | Perno comercial de suspensión tratado;9/16 in, grado, hombro y longitud OEM a confirmar. | 15654.891 | 25.40×90.00×22.00 | Incluido en la línea de compra M14; no sumar precio por cada sólido.
SU-EQENDPIN--1-0-NUT | Tuerca autofrenante de perno9/16 | SUSP | 1 | M14 | Acero y sistema de autofrenado de kit; representación sin hélice. | 3285.318 | 25.40×12.00×22.00 | Incluido en la línea de compra M14; no sumar precio por cada sólido.
SU-CENTERBOLT--1-0 | Perno central y tuerca alojados sin interferencia · S02-A | SUSP | 1 | M13 | Perno de resorteOEM, diámetro9 de representación. | 2932.892 | 15.01×13.00×39.38 | Incluido en la línea de compra M13; no sumar precio por cada sólido.
SU-LEAF--1-1-0 | Hoja maestra con ojos · elástico doble ojo | SUSP | 1 | M13 | Acero para resortes y tratamiento térmico según fabricante; noS235 ni caño estructural. | 222178.309 | 694.29×44.45×67.49 | Incluido en la línea de compra M13; no sumar precio por cada sólido.
SU-LEAF--1-1-1 | Hoja graduada1 del paquete de elástico | SUSP | 1 | M13 | Acero para resortes y tratamiento térmico según fabricante; noS235 ni caño estructural. | 140620.686 | 530.00×44.45×23.60 | Incluido en la línea de compra M13; no sumar precio por cada sólido.
SU-LEAF--1-1-2 | Hoja graduada2 del paquete de elástico | SUSP | 1 | M13 | Acero para resortes y tratamiento térmico según fabricante; noS235 ni caño estructural. | 106128.82 | 400.00×44.45×16.01 | Incluido en la línea de compra M13; no sumar precio por cada sólido.
SU-LEAF--1-1-3 | Hoja graduada3 del paquete de elástico | SUSP | 1 | M13 | Acero para resortes y tratamiento térmico según fabricante; noS235 ni caño estructural. | 71636.953 | 270.00×44.45×10.55 | Incluido en la línea de compra M13; no sumar precio por cada sólido.
SU-BUSH--1-1-0 | Buje de ojo de elástico | SUSP | 1 | M14 | Bronce engrasable o buje especificado por proveedor; versión final única por kit. | 10066.572 | 22.19×44.45×22.17 | Incluido en la línea de compra M14; no sumar precio por cada sólido.
SU-BUSH--1-1-1 | Buje de ojo de elástico | SUSP | 1 | M14 | Bronce engrasable o buje especificado por proveedor; versión final única por kit. | 10066.572 | 22.19×44.45×22.17 | Incluido en la línea de compra M14; no sumar precio por cada sólido.
SU-SHACKLE--1-1--1 | Gemela articulada57.15 mm entre centros | SUSP | 1 | M14 | Gemela comercial de acero de kit,6 mm de espesor representado; no acero de resorte. | 13816.727 | 49.46×6.00×86.38 | Incluido en la línea de compra M14; no sumar precio por cada sólido.
SU-SHACKLE--1-1-1 | Gemela articulada57.15 mm entre centros | SUSP | 1 | M14 | Gemela comercial de acero de kit,6 mm de espesor representado; no acero de resorte. | 13816.727 | 49.46×6.00×86.38 | Incluido en la línea de compra M14; no sumar precio por cada sólido.
SU-INNERPIN--1-1 | Pivote de ojo interior · perno húmedo9/16 | SUSP | 1 | M14 | Perno comercial de suspensión tratado;9/16 in, grado, hombro y longitud OEM a confirmar. | 15654.891 | 25.40×90.00×22.00 | Incluido en la línea de compra M14; no sumar precio por cada sólido.
SU-INNERPIN--1-1-NUT | Tuerca autofrenante de perno9/16 | SUSP | 1 | M14 | Acero y sistema de autofrenado de kit; representación sin hélice. | 3285.318 | 25.40×12.00×22.00 | Incluido en la línea de compra M14; no sumar precio por cada sólido.
SU-EQENDPIN--1-1 | Pivote lateral de balancín · perno húmedo9/16 | SUSP | 1 | M14 | Perno comercial de suspensión tratado;9/16 in, grado, hombro y longitud OEM a confirmar. | 15654.891 | 25.40×90.00×22.00 | Incluido en la línea de compra M14; no sumar precio por cada sólido.
SU-EQENDPIN--1-1-NUT | Tuerca autofrenante de perno9/16 | SUSP | 1 | M14 | Acero y sistema de autofrenado de kit; representación sin hélice. | 3285.318 | 25.40×12.00×22.00 | Incluido en la línea de compra M14; no sumar precio por cada sólido.
SU-CENTERBOLT--1-1 | Perno central del paquete de elástico | SUSP | 1 | M13 | Perno de resorteOEM, diámetro9 de representación. | 2990.509 | 14.00×12.12×40.00 | Incluido en la línea de compra M13; no sumar precio por cada sólido.
SU-HANGER-1-0 | Soporte fijo de ojo extremo, doble cizalla | SUSP | 1 | M07 | ChapaS235 e6, dos orejas paralelas; distancial libre45.45 mm de proyecto. | 128032.341 | 90.00×57.45×120.38 | Incluido en la línea de compra M07; no sumar precio por cada sólido.
SU-PIN-1-0 | Pivote de ojo fijo · perno húmedo9/16 | SUSP | 1 | M14 | Perno comercial de suspensión tratado;9/16 in, grado, hombro y longitud OEM a confirmar. | 15654.891 | 25.40×90.00×22.00 | Incluido en la línea de compra M14; no sumar precio por cada sólido.
SU-PIN-1-0-NUT | Tuerca autofrenante de perno9/16 | SUSP | 1 | M14 | Acero y sistema de autofrenado de kit; representación sin hélice. | 3285.318 | 25.40×12.00×22.00 | Incluido en la línea de compra M14; no sumar precio por cada sólido.
SU-HANGER-1-1 | Soporte central de balancín, doble cizalla | SUSP | 1 | M07 | ChapaS235 e6, dos orejas paralelas; distancial libre45.45 mm de proyecto. | 131938.44 | 90.00×57.45×124.00 | Incluido en la línea de compra M07; no sumar precio por cada sólido.
SU-PIN-1-1 | Pivote central de balancín · perno húmedo9/16 | SUSP | 1 | M14 | Perno comercial de suspensión tratado;9/16 in, grado, hombro y longitud OEM a confirmar. | 15654.891 | 25.40×90.00×22.00 | Incluido en la línea de compra M14; no sumar precio por cada sólido.
SU-PIN-1-1-NUT | Tuerca autofrenante de perno9/16 | SUSP | 1 | M14 | Acero y sistema de autofrenado de kit; representación sin hélice. | 3285.318 | 25.40×12.00×22.00 | Incluido en la línea de compra M14; no sumar precio por cada sólido.
SU-HANGER-1-2 | Soporte fijo de ojo extremo, doble cizalla | SUSP | 1 | M07 | ChapaS235 e6, dos orejas paralelas; distancial libre45.45 mm de proyecto. | 128032.341 | 90.00×57.45×120.38 | Incluido en la línea de compra M07; no sumar precio por cada sólido.
SU-PIN-1-2 | Pivote de ojo fijo · perno húmedo9/16 | SUSP | 1 | M14 | Perno comercial de suspensión tratado;9/16 in, grado, hombro y longitud OEM a confirmar. | 15654.891 | 25.40×90.00×22.00 | Incluido en la línea de compra M14; no sumar precio por cada sólido.
SU-PIN-1-2-NUT | Tuerca autofrenante de perno9/16 | SUSP | 1 | M14 | Acero y sistema de autofrenado de kit; representación sin hélice. | 3285.318 | 25.40×12.00×22.00 | Incluido en la línea de compra M14; no sumar precio por cada sólido.
SU-EQUALIZER-1 | Balancín compensador142.875×50.8 · referencia013-104-02 | SUSP | 1 | M14 | Componente fundido/comercial de suspensión; materialOEM y capacidad por confirmar. | 577084.265 | 212.00×44.45×88.00 | Incluido en la línea de compra M14; no sumar precio por cada sólido.
SU-EQBUSH-1-0 | Buje de balancín bronceØ22.2/14.3×44.45 | SUSP | 1 | M14 | Bronce de kit engrasable, compatibilidad con fundición y perno por confirmar. | 10066.572 | 22.19×44.45×22.17 | Incluido en la línea de compra M14; no sumar precio por cada sólido.
SU-EQBUSH-1-1 | Buje de balancín bronceØ22.2/14.3×44.45 | SUSP | 1 | M14 | Bronce de kit engrasable, compatibilidad con fundición y perno por confirmar. | 10066.572 | 22.19×44.45×22.17 | Incluido en la línea de compra M14; no sumar precio por cada sólido.
SU-EQBUSH-1-2 | Buje de balancín bronceØ22.2/14.3×44.45 | SUSP | 1 | M14 | Bronce de kit engrasable, compatibilidad con fundición y perno por confirmar. | 10066.572 | 22.19×44.45×22.17 | Incluido en la línea de compra M14; no sumar precio por cada sólido.
SU-LEAF-1-0-0 | Hoja maestra con ojos · elástico doble ojo | SUSP | 1 | M13 | Acero para resortes y tratamiento térmico según fabricante; noS235 ni caño estructural. | 222178.309 | 694.29×44.45×67.49 | Incluido en la línea de compra M13; no sumar precio por cada sólido.
SU-LEAF-1-0-1 | Hoja graduada1 del paquete de elástico | SUSP | 1 | M13 | Acero para resortes y tratamiento térmico según fabricante; noS235 ni caño estructural. | 140620.686 | 530.00×44.45×23.60 | Incluido en la línea de compra M13; no sumar precio por cada sólido.
SU-LEAF-1-0-2 | Hoja graduada2 del paquete de elástico | SUSP | 1 | M13 | Acero para resortes y tratamiento térmico según fabricante; noS235 ni caño estructural. | 106128.82 | 400.00×44.45×16.01 | Incluido en la línea de compra M13; no sumar precio por cada sólido.
SU-LEAF-1-0-3 | Hoja graduada3 del paquete de elástico | SUSP | 1 | M13 | Acero para resortes y tratamiento térmico según fabricante; noS235 ni caño estructural. | 71636.953 | 270.00×44.45×10.55 | Incluido en la línea de compra M13; no sumar precio por cada sólido.
SU-BUSH-1-0-0 | Buje de ojo de elástico | SUSP | 1 | M14 | Bronce engrasable o buje especificado por proveedor; versión final única por kit. | 10066.572 | 22.19×44.45×22.17 | Incluido en la línea de compra M14; no sumar precio por cada sólido.
SU-BUSH-1-0-1 | Buje de ojo de elástico | SUSP | 1 | M14 | Bronce engrasable o buje especificado por proveedor; versión final única por kit. | 10066.572 | 22.19×44.45×22.17 | Incluido en la línea de compra M14; no sumar precio por cada sólido.
SU-SHACKLE-1-0--1 | Gemela articulada57.15 mm entre centros | SUSP | 1 | M14 | Gemela comercial de acero de kit,6 mm de espesor representado; no acero de resorte. | 13816.727 | 49.46×6.00×86.38 | Incluido en la línea de compra M14; no sumar precio por cada sólido.
SU-SHACKLE-1-0-1 | Gemela articulada57.15 mm entre centros | SUSP | 1 | M14 | Gemela comercial de acero de kit,6 mm de espesor representado; no acero de resorte. | 13816.727 | 49.46×6.00×86.38 | Incluido en la línea de compra M14; no sumar precio por cada sólido.
SU-INNERPIN-1-0 | Pivote de ojo interior · perno húmedo9/16 | SUSP | 1 | M14 | Perno comercial de suspensión tratado;9/16 in, grado, hombro y longitud OEM a confirmar. | 15654.891 | 25.40×90.00×22.00 | Incluido en la línea de compra M14; no sumar precio por cada sólido.
SU-INNERPIN-1-0-NUT | Tuerca autofrenante de perno9/16 | SUSP | 1 | M14 | Acero y sistema de autofrenado de kit; representación sin hélice. | 3285.318 | 25.40×12.00×22.00 | Incluido en la línea de compra M14; no sumar precio por cada sólido.
SU-EQENDPIN-1-0 | Pivote lateral de balancín · perno húmedo9/16 | SUSP | 1 | M14 | Perno comercial de suspensión tratado;9/16 in, grado, hombro y longitud OEM a confirmar. | 15654.891 | 25.40×90.00×22.00 | Incluido en la línea de compra M14; no sumar precio por cada sólido.
SU-EQENDPIN-1-0-NUT | Tuerca autofrenante de perno9/16 | SUSP | 1 | M14 | Acero y sistema de autofrenado de kit; representación sin hélice. | 3285.318 | 25.40×12.00×22.00 | Incluido en la línea de compra M14; no sumar precio por cada sólido.
SU-CENTERBOLT-1-0 | Perno central del paquete de elástico | SUSP | 1 | M13 | Perno de resorteOEM, diámetro9 de representación. | 2990.509 | 14.00×12.12×40.00 | Incluido en la línea de compra M13; no sumar precio por cada sólido.
SU-LEAF-1-1-0 | Hoja maestra con ojos · elástico doble ojo | SUSP | 1 | M13 | Acero para resortes y tratamiento térmico según fabricante; noS235 ni caño estructural. | 222178.309 | 694.29×44.45×67.49 | Incluido en la línea de compra M13; no sumar precio por cada sólido.
SU-LEAF-1-1-1 | Hoja graduada1 del paquete de elástico | SUSP | 1 | M13 | Acero para resortes y tratamiento térmico según fabricante; noS235 ni caño estructural. | 140620.686 | 530.00×44.45×23.60 | Incluido en la línea de compra M13; no sumar precio por cada sólido.
SU-LEAF-1-1-2 | Hoja graduada2 del paquete de elástico | SUSP | 1 | M13 | Acero para resortes y tratamiento térmico según fabricante; noS235 ni caño estructural. | 106128.82 | 400.00×44.45×16.01 | Incluido en la línea de compra M13; no sumar precio por cada sólido.
SU-LEAF-1-1-3 | Hoja graduada3 del paquete de elástico | SUSP | 1 | M13 | Acero para resortes y tratamiento térmico según fabricante; noS235 ni caño estructural. | 71636.953 | 270.00×44.45×10.55 | Incluido en la línea de compra M13; no sumar precio por cada sólido.
SU-BUSH-1-1-0 | Buje de ojo de elástico | SUSP | 1 | M14 | Bronce engrasable o buje especificado por proveedor; versión final única por kit. | 10066.572 | 22.19×44.45×22.17 | Incluido en la línea de compra M14; no sumar precio por cada sólido.
SU-BUSH-1-1-1 | Buje de ojo de elástico | SUSP | 1 | M14 | Bronce engrasable o buje especificado por proveedor; versión final única por kit. | 10066.572 | 22.19×44.45×22.17 | Incluido en la línea de compra M14; no sumar precio por cada sólido.
SU-SHACKLE-1-1--1 | Gemela articulada57.15 mm entre centros | SUSP | 1 | M14 | Gemela comercial de acero de kit,6 mm de espesor representado; no acero de resorte. | 13816.727 | 49.46×6.00×86.38 | Incluido en la línea de compra M14; no sumar precio por cada sólido.
SU-SHACKLE-1-1-1 | Gemela articulada57.15 mm entre centros | SUSP | 1 | M14 | Gemela comercial de acero de kit,6 mm de espesor representado; no acero de resorte. | 13816.727 | 49.46×6.00×86.38 | Incluido en la línea de compra M14; no sumar precio por cada sólido.
SU-INNERPIN-1-1 | Pivote de ojo interior · perno húmedo9/16 | SUSP | 1 | M14 | Perno comercial de suspensión tratado;9/16 in, grado, hombro y longitud OEM a confirmar. | 15654.891 | 25.40×90.00×22.00 | Incluido en la línea de compra M14; no sumar precio por cada sólido.
SU-INNERPIN-1-1-NUT | Tuerca autofrenante de perno9/16 | SUSP | 1 | M14 | Acero y sistema de autofrenado de kit; representación sin hélice. | 3285.318 | 25.40×12.00×22.00 | Incluido en la línea de compra M14; no sumar precio por cada sólido.
SU-EQENDPIN-1-1 | Pivote lateral de balancín · perno húmedo9/16 | SUSP | 1 | M14 | Perno comercial de suspensión tratado;9/16 in, grado, hombro y longitud OEM a confirmar. | 15654.891 | 25.40×90.00×22.00 | Incluido en la línea de compra M14; no sumar precio por cada sólido.
SU-EQENDPIN-1-1-NUT | Tuerca autofrenante de perno9/16 | SUSP | 1 | M14 | Acero y sistema de autofrenado de kit; representación sin hélice. | 3285.318 | 25.40×12.00×22.00 | Incluido en la línea de compra M14; no sumar precio por cada sólido.
SU-CENTERBOLT-1-1 | Perno central del paquete de elástico | SUSP | 1 | M13 | Perno de resorteOEM, diámetro9 de representación. | 2990.509 | 14.00×12.12×40.00 | Incluido en la línea de compra M13; no sumar precio por cada sólido.
RU-AXLETUBE-0 | Viga de eje recto claseD35 Ø60.325 | RUN | 1 | M09 | Tubo y manguetas de eje homologado; pared4 mm es hipótesis visual, no especificación para fabricar eje. | 1486381.732 | 59.89×2100.00×60.32 | Incluido en la línea de compra M09; no sumar precio por cada sólido.
RU-SEAT-0--1 | Asiento de ballesta con alojamiento de cabeza · S02-A | RUN | 1 | M16 | Acero de asientoOEM; representación90×50 y10 mm de altura útil sobre tubo. | 68793.878 | 90.00×50.00×18.00 | Incluido en la línea de compra M16; no sumar precio por cada sólido.
RU-TIEPLATE-0--1 | Placa de apriete con acceso al perno central · S02-A | SUSP | 1 | M07 | Placa de suspensión comercial e10 o espesor validado por proveedor. | 99593.474 | 110.00×100.00×10.00 | Incluido en la línea de compra M07; no sumar precio por cada sólido.
RU-UBOLT-0--1-0 | Abrazadera continua de desarrollo Ø12,7 · S02-A | SUSP | 1 | M15 | Abrazadera comercial1/2 in con grado, radio y rosca según proveedor. Curva modelada por segmentos. | 39369.195 | 85.73×12.68×140.90 | Incluido en la línea de compra M15; no sumar precio por cada sólido.
RU-UNUT-0--1-0--1 | Tuerca y arandela de abrazadera · rosca simplificada · S02-A | SUSP | 1 | M15 | Tuerca de clase y paso correspondientes alU; no mezclar roscas1/2UNF/UNC. | 2934.415 | 26.00×25.96×14.00 | Incluido en la línea de compra M15; no sumar precio por cada sólido.
RU-UNUT-0--1-0-1 | Tuerca y arandela de abrazadera · rosca simplificada · S02-A | SUSP | 1 | M15 | Tuerca de clase y paso correspondientes alU; no mezclar roscas1/2UNF/UNC. | 2934.415 | 26.00×25.96×14.00 | Incluido en la línea de compra M15; no sumar precio por cada sólido.
RU-UBOLT-0--1-1 | Abrazadera continua de desarrollo Ø12,7 · S02-A | SUSP | 1 | M15 | Abrazadera comercial1/2 in con grado, radio y rosca según proveedor. Curva modelada por segmentos. | 39369.195 | 85.73×12.68×140.90 | Incluido en la línea de compra M15; no sumar precio por cada sólido.
RU-UNUT-0--1-1--1 | Tuerca y arandela de abrazadera · rosca simplificada · S02-A | SUSP | 1 | M15 | Tuerca de clase y paso correspondientes alU; no mezclar roscas1/2UNF/UNC. | 2934.415 | 26.00×25.96×14.00 | Incluido en la línea de compra M15; no sumar precio por cada sólido.
RU-UNUT-0--1-1-1 | Tuerca y arandela de abrazadera · rosca simplificada · S02-A | SUSP | 1 | M15 | Tuerca de clase y paso correspondientes alU; no mezclar roscas1/2UNF/UNC. | 2934.415 | 26.00×25.96×14.00 | Incluido en la línea de compra M15; no sumar precio por cada sólido.
RU-SEAT-0-1 | Asiento de elástico para tuboØ60.325 | RUN | 1 | M16 | Acero de asientoOEM; representación90×50 y10 mm de altura útil sobre tubo. | 68967.867 | 90.00×50.00×18.00 | Incluido en la línea de compra M16; no sumar precio por cada sólido.
RU-TIEPLATE-0-1 | Placa superior de abrazaderas de elástico110×100×10 | SUSP | 1 | M07 | Placa de suspensión comercial e10 o espesor validado por proveedor. | 104274.447 | 110.00×100.00×10.00 | Incluido en la línea de compra M07; no sumar precio por cada sólido.
RU-UBOLT-0-1-0 | AbrazaderaU comercial1/2 in para eje2⅜ in | SUSP | 1 | M15 | Abrazadera comercial1/2 in con grado, radio y rosca según proveedor. Curva modelada por segmentos. | 39188.843 | 85.02×12.61×140.50 | Incluido en la línea de compra M15; no sumar precio por cada sólido.
RU-UNUT-0-1-0--1 | Tuerca y arandela de abrazadera1/2 | SUSP | 1 | M15 | Tuerca de clase y paso correspondientes alU; no mezclar roscas1/2UNF/UNC. | 3541.56 | 26.00×25.96×14.00 | Incluido en la línea de compra M15; no sumar precio por cada sólido.
RU-UNUT-0-1-0-1 | Tuerca y arandela de abrazadera1/2 | SUSP | 1 | M15 | Tuerca de clase y paso correspondientes alU; no mezclar roscas1/2UNF/UNC. | 3541.56 | 26.00×25.96×14.00 | Incluido en la línea de compra M15; no sumar precio por cada sólido.
RU-UBOLT-0-1-1 | AbrazaderaU comercial1/2 in para eje2⅜ in | SUSP | 1 | M15 | Abrazadera comercial1/2 in con grado, radio y rosca según proveedor. Curva modelada por segmentos. | 39188.843 | 85.02×12.61×140.50 | Incluido en la línea de compra M15; no sumar precio por cada sólido.
RU-UNUT-0-1-1--1 | Tuerca y arandela de abrazadera1/2 | SUSP | 1 | M15 | Tuerca de clase y paso correspondientes alU; no mezclar roscas1/2UNF/UNC. | 3541.56 | 26.00×25.96×14.00 | Incluido en la línea de compra M15; no sumar precio por cada sólido.
RU-UNUT-0-1-1-1 | Tuerca y arandela de abrazadera1/2 | SUSP | 1 | M15 | Tuerca de clase y paso correspondientes alU; no mezclar roscas1/2UNF/UNC. | 3541.56 | 26.00×25.96×14.00 | Incluido en la línea de compra M15; no sumar precio por cada sólido.
RU-SPINDLE-0--1 | Mangueta escalonada de eje, representación de interfaz | RUN | 1 | M09 | Mangueta forjada/mecanizada de ejeOEM; material y tratamiento no inferidos. | 184458.456 | 53.96×130.00×53.92 | Incluido en la línea de compra M09; no sumar precio por cada sólido.
RU-BACKPLATE-0--1 | Plato portafreno254×57.15 eléctrico con estacionamiento | RUN | 1 | M09 | Conjunto comercial de freno; acero estampado y mecanismosOEM. | 272140.464 | 269.91×5.00×269.82 | Incluido en la línea de compra M09; no sumar precio por cada sólido.
RU-SHOE-0--1-0 | Zapata y forro de freno1 | RUN | 1 | M09 | Forro sin asbesto y acero según frenoOEM; coeficiente no supuesto. | 103782.261 | 229.30×57.15×75.79 | Incluido en la línea de compra M09; no sumar precio por cada sólido.
RU-SHOE-0--1-1 | Zapata y forro de freno2 | RUN | 1 | M09 | Forro sin asbesto y acero según frenoOEM; coeficiente no supuesto. | 103782.261 | 229.30×57.15×75.79 | Incluido en la línea de compra M09; no sumar precio por cada sólido.
RU-MAGNET-0--1 | Imán de freno eléctrico12V y brazo | RUN | 1 | M09 | Conjunto electromagnéticoOEM; forma exterior indicativa. | 50605.672 | 80.77×36.96×181.49 | Incluido en la línea de compra M09; no sumar precio por cada sólido.
RU-DRUM-0--1 | Tambor-maza5×114.3 · conjunto de compra | RUN | 1 | M09 | Tambor-maza de fundición especificada por proveedor, rodamientos y reténOEM. | 1919896.386 | 275.53×154.00×276.00 | Incluido en la línea de compra M09; no sumar precio por cada sólido.
RU-BEARINGS-0--1 | Rodamientos, retén y tapa de maza | RUN | 1 | M09 | Rodamientos de rodillos cónicos y retén de elastómero según manguetaOEM. | 83346.265 | 57.86×90.00×58.00 | Incluido en la línea de compra M09; no sumar precio por cada sólido.
RU-TIRE-0--1 | NeumáticoST205/75R15 107N D | RUN | 1 | M11 | Neumático comercialST para trailer; carcasa y compuesto según fabricante. | 49988389.543 | 687.82×203.20×688.08 | Incluido en la línea de compra M11; no sumar precio por cada sólido.
RU-RIM-0--1 | Llanta15×5.5 · cinco agujeros | RUN | 1 | M12 | Llanta de acero comercial para trailer,capacidad mínima recomendada>=975 kg y presión>=65 psi; certificado requerido. | 1746086.908 | 396.00×149.70×396.00 | Incluido en la línea de compra M12; no sumar precio por cada sólido.
RU-STUDNUT-0--1-0 | Espárrago y tuerca cónica de rueda1/2-20 | RUN | 1 | M09 | Espárrago de maza y tuerca de ruedaOEM1/2-20, no intercambiar conM12. | 7249.046 | 22.00×35.00×19.05 | Incluido en la línea de compra M09; no sumar precio por cada sólido.
RU-STUDNUT-0--1-1 | Espárrago y tuerca cónica de rueda1/2-20 | RUN | 1 | M09 | Espárrago de maza y tuerca de ruedaOEM1/2-20, no intercambiar conM12. | 7249.046 | 22.00×35.00×19.05 | Incluido en la línea de compra M09; no sumar precio por cada sólido.
RU-STUDNUT-0--1-2 | Espárrago y tuerca cónica de rueda1/2-20 | RUN | 1 | M09 | Espárrago de maza y tuerca de ruedaOEM1/2-20, no intercambiar conM12. | 7249.046 | 22.00×35.00×19.05 | Incluido en la línea de compra M09; no sumar precio por cada sólido.
RU-STUDNUT-0--1-3 | Espárrago y tuerca cónica de rueda1/2-20 | RUN | 1 | M09 | Espárrago de maza y tuerca de ruedaOEM1/2-20, no intercambiar conM12. | 7249.046 | 22.00×35.00×19.05 | Incluido en la línea de compra M09; no sumar precio por cada sólido.
RU-STUDNUT-0--1-4 | Espárrago y tuerca cónica de rueda1/2-20 | RUN | 1 | M09 | Espárrago de maza y tuerca de ruedaOEM1/2-20, no intercambiar conM12. | 7249.046 | 22.00×35.00×19.05 | Incluido en la línea de compra M09; no sumar precio por cada sólido.
RU-SPINDLE-0-1 | Mangueta escalonada de eje, representación de interfaz | RUN | 1 | M09 | Mangueta forjada/mecanizada de ejeOEM; material y tratamiento no inferidos. | 184458.456 | 53.96×130.00×53.92 | Incluido en la línea de compra M09; no sumar precio por cada sólido.
RU-BACKPLATE-0-1 | Plato portafreno254×57.15 eléctrico con estacionamiento | RUN | 1 | M09 | Conjunto comercial de freno; acero estampado y mecanismosOEM. | 272140.464 | 269.91×5.00×269.82 | Incluido en la línea de compra M09; no sumar precio por cada sólido.
RU-SHOE-0-1-0 | Zapata y forro de freno1 | RUN | 1 | M09 | Forro sin asbesto y acero según frenoOEM; coeficiente no supuesto. | 103782.261 | 229.30×57.15×75.79 | Incluido en la línea de compra M09; no sumar precio por cada sólido.
RU-SHOE-0-1-1 | Zapata y forro de freno2 | RUN | 1 | M09 | Forro sin asbesto y acero según frenoOEM; coeficiente no supuesto. | 103782.261 | 229.30×57.15×75.79 | Incluido en la línea de compra M09; no sumar precio por cada sólido.
RU-MAGNET-0-1 | Imán de freno eléctrico12V y brazo | RUN | 1 | M09 | Conjunto electromagnéticoOEM; forma exterior indicativa. | 50605.672 | 80.77×36.96×181.49 | Incluido en la línea de compra M09; no sumar precio por cada sólido.
RU-DRUM-0-1 | Tambor-maza5×114.3 · conjunto de compra | RUN | 1 | M09 | Tambor-maza de fundición especificada por proveedor, rodamientos y reténOEM. | 1919896.386 | 275.53×154.00×276.00 | Incluido en la línea de compra M09; no sumar precio por cada sólido.
RU-BEARINGS-0-1 | Rodamientos, retén y tapa de maza | RUN | 1 | M09 | Rodamientos de rodillos cónicos y retén de elastómero según manguetaOEM. | 83346.265 | 57.86×90.00×58.00 | Incluido en la línea de compra M09; no sumar precio por cada sólido.
RU-TIRE-0-1 | NeumáticoST205/75R15 107N D | RUN | 1 | M11 | Neumático comercialST para trailer; carcasa y compuesto según fabricante. | 49988389.543 | 687.82×203.20×688.08 | Incluido en la línea de compra M11; no sumar precio por cada sólido.
RU-RIM-0-1 | Llanta15×5.5 · cinco agujeros | RUN | 1 | M12 | Llanta de acero comercial para trailer,capacidad mínima recomendada>=975 kg y presión>=65 psi; certificado requerido. | 1746086.908 | 396.00×149.70×396.00 | Incluido en la línea de compra M12; no sumar precio por cada sólido.
RU-STUDNUT-0-1-0 | Espárrago y tuerca cónica de rueda1/2-20 | RUN | 1 | M09 | Espárrago de maza y tuerca de ruedaOEM1/2-20, no intercambiar conM12. | 7249.046 | 22.00×35.00×19.05 | Incluido en la línea de compra M09; no sumar precio por cada sólido.
RU-STUDNUT-0-1-1 | Espárrago y tuerca cónica de rueda1/2-20 | RUN | 1 | M09 | Espárrago de maza y tuerca de ruedaOEM1/2-20, no intercambiar conM12. | 7249.046 | 22.00×35.00×19.05 | Incluido en la línea de compra M09; no sumar precio por cada sólido.
RU-STUDNUT-0-1-2 | Espárrago y tuerca cónica de rueda1/2-20 | RUN | 1 | M09 | Espárrago de maza y tuerca de ruedaOEM1/2-20, no intercambiar conM12. | 7249.046 | 22.00×35.00×19.05 | Incluido en la línea de compra M09; no sumar precio por cada sólido.
RU-STUDNUT-0-1-3 | Espárrago y tuerca cónica de rueda1/2-20 | RUN | 1 | M09 | Espárrago de maza y tuerca de ruedaOEM1/2-20, no intercambiar conM12. | 7249.046 | 22.00×35.00×19.05 | Incluido en la línea de compra M09; no sumar precio por cada sólido.
RU-STUDNUT-0-1-4 | Espárrago y tuerca cónica de rueda1/2-20 | RUN | 1 | M09 | Espárrago de maza y tuerca de ruedaOEM1/2-20, no intercambiar conM12. | 7249.046 | 22.00×35.00×19.05 | Incluido en la línea de compra M09; no sumar precio por cada sólido.
RU-AXLETUBE-1 | Viga de eje recto claseD35 Ø60.325 | RUN | 1 | M09 | Tubo y manguetas de eje homologado; pared4 mm es hipótesis visual, no especificación para fabricar eje. | 1486381.732 | 59.89×2100.00×60.32 | Incluido en la línea de compra M09; no sumar precio por cada sólido.
RU-SEAT-1--1 | Asiento de elástico para tuboØ60.325 | RUN | 1 | M16 | Acero de asientoOEM; representación90×50 y10 mm de altura útil sobre tubo. | 68967.867 | 90.00×50.00×18.00 | Incluido en la línea de compra M16; no sumar precio por cada sólido.
RU-TIEPLATE-1--1 | Placa superior de abrazaderas de elástico110×100×10 | SUSP | 1 | M07 | Placa de suspensión comercial e10 o espesor validado por proveedor. | 104274.447 | 110.00×100.00×10.00 | Incluido en la línea de compra M07; no sumar precio por cada sólido.
RU-UBOLT-1--1-0 | AbrazaderaU comercial1/2 in para eje2⅜ in | SUSP | 1 | M15 | Abrazadera comercial1/2 in con grado, radio y rosca según proveedor. Curva modelada por segmentos. | 39188.843 | 85.02×12.61×140.50 | Incluido en la línea de compra M15; no sumar precio por cada sólido.
RU-UNUT-1--1-0--1 | Tuerca y arandela de abrazadera1/2 | SUSP | 1 | M15 | Tuerca de clase y paso correspondientes alU; no mezclar roscas1/2UNF/UNC. | 3541.56 | 26.00×25.96×14.00 | Incluido en la línea de compra M15; no sumar precio por cada sólido.
RU-UNUT-1--1-0-1 | Tuerca y arandela de abrazadera1/2 | SUSP | 1 | M15 | Tuerca de clase y paso correspondientes alU; no mezclar roscas1/2UNF/UNC. | 3541.56 | 26.00×25.96×14.00 | Incluido en la línea de compra M15; no sumar precio por cada sólido.
RU-UBOLT-1--1-1 | AbrazaderaU comercial1/2 in para eje2⅜ in | SUSP | 1 | M15 | Abrazadera comercial1/2 in con grado, radio y rosca según proveedor. Curva modelada por segmentos. | 39188.843 | 85.02×12.61×140.50 | Incluido en la línea de compra M15; no sumar precio por cada sólido.
RU-UNUT-1--1-1--1 | Tuerca y arandela de abrazadera1/2 | SUSP | 1 | M15 | Tuerca de clase y paso correspondientes alU; no mezclar roscas1/2UNF/UNC. | 3541.56 | 26.00×25.96×14.00 | Incluido en la línea de compra M15; no sumar precio por cada sólido.
RU-UNUT-1--1-1-1 | Tuerca y arandela de abrazadera1/2 | SUSP | 1 | M15 | Tuerca de clase y paso correspondientes alU; no mezclar roscas1/2UNF/UNC. | 3541.56 | 26.00×25.96×14.00 | Incluido en la línea de compra M15; no sumar precio por cada sólido.
RU-SEAT-1-1 | Asiento de elástico para tuboØ60.325 | RUN | 1 | M16 | Acero de asientoOEM; representación90×50 y10 mm de altura útil sobre tubo. | 68967.867 | 90.00×50.00×18.00 | Incluido en la línea de compra M16; no sumar precio por cada sólido.
RU-TIEPLATE-1-1 | Placa superior de abrazaderas de elástico110×100×10 | SUSP | 1 | M07 | Placa de suspensión comercial e10 o espesor validado por proveedor. | 104274.447 | 110.00×100.00×10.00 | Incluido en la línea de compra M07; no sumar precio por cada sólido.
RU-UBOLT-1-1-0 | AbrazaderaU comercial1/2 in para eje2⅜ in | SUSP | 1 | M15 | Abrazadera comercial1/2 in con grado, radio y rosca según proveedor. Curva modelada por segmentos. | 39188.843 | 85.02×12.61×140.50 | Incluido en la línea de compra M15; no sumar precio por cada sólido.
RU-UNUT-1-1-0--1 | Tuerca y arandela de abrazadera1/2 | SUSP | 1 | M15 | Tuerca de clase y paso correspondientes alU; no mezclar roscas1/2UNF/UNC. | 3541.56 | 26.00×25.96×14.00 | Incluido en la línea de compra M15; no sumar precio por cada sólido.
RU-UNUT-1-1-0-1 | Tuerca y arandela de abrazadera1/2 | SUSP | 1 | M15 | Tuerca de clase y paso correspondientes alU; no mezclar roscas1/2UNF/UNC. | 3541.56 | 26.00×25.96×14.00 | Incluido en la línea de compra M15; no sumar precio por cada sólido.
RU-UBOLT-1-1-1 | AbrazaderaU comercial1/2 in para eje2⅜ in | SUSP | 1 | M15 | Abrazadera comercial1/2 in con grado, radio y rosca según proveedor. Curva modelada por segmentos. | 39188.843 | 85.02×12.61×140.50 | Incluido en la línea de compra M15; no sumar precio por cada sólido.
RU-UNUT-1-1-1--1 | Tuerca y arandela de abrazadera1/2 | SUSP | 1 | M15 | Tuerca de clase y paso correspondientes alU; no mezclar roscas1/2UNF/UNC. | 3541.56 | 26.00×25.96×14.00 | Incluido en la línea de compra M15; no sumar precio por cada sólido.
RU-UNUT-1-1-1-1 | Tuerca y arandela de abrazadera1/2 | SUSP | 1 | M15 | Tuerca de clase y paso correspondientes alU; no mezclar roscas1/2UNF/UNC. | 3541.56 | 26.00×25.96×14.00 | Incluido en la línea de compra M15; no sumar precio por cada sólido.
RU-SPINDLE-1--1 | Mangueta escalonada de eje, representación de interfaz | RUN | 1 | M09 | Mangueta forjada/mecanizada de ejeOEM; material y tratamiento no inferidos. | 184458.456 | 53.96×130.00×53.92 | Incluido en la línea de compra M09; no sumar precio por cada sólido.
RU-BACKPLATE-1--1 | Plato portafreno254×57.15 eléctrico con estacionamiento | RUN | 1 | M09 | Conjunto comercial de freno; acero estampado y mecanismosOEM. | 272140.464 | 269.91×5.00×269.82 | Incluido en la línea de compra M09; no sumar precio por cada sólido.
RU-SHOE-1--1-0 | Zapata y forro de freno1 | RUN | 1 | M09 | Forro sin asbesto y acero según frenoOEM; coeficiente no supuesto. | 103782.261 | 229.30×57.15×75.79 | Incluido en la línea de compra M09; no sumar precio por cada sólido.
RU-SHOE-1--1-1 | Zapata y forro de freno2 | RUN | 1 | M09 | Forro sin asbesto y acero según frenoOEM; coeficiente no supuesto. | 103782.261 | 229.30×57.15×75.79 | Incluido en la línea de compra M09; no sumar precio por cada sólido.
RU-MAGNET-1--1 | Imán de freno eléctrico12V y brazo | RUN | 1 | M09 | Conjunto electromagnéticoOEM; forma exterior indicativa. | 50605.672 | 80.77×36.96×181.49 | Incluido en la línea de compra M09; no sumar precio por cada sólido.
RU-DRUM-1--1 | Tambor-maza5×114.3 · conjunto de compra | RUN | 1 | M09 | Tambor-maza de fundición especificada por proveedor, rodamientos y reténOEM. | 1919896.386 | 275.53×154.00×276.00 | Incluido en la línea de compra M09; no sumar precio por cada sólido.
RU-BEARINGS-1--1 | Rodamientos, retén y tapa de maza | RUN | 1 | M09 | Rodamientos de rodillos cónicos y retén de elastómero según manguetaOEM. | 83346.265 | 57.86×90.00×58.00 | Incluido en la línea de compra M09; no sumar precio por cada sólido.
RU-TIRE-1--1 | NeumáticoST205/75R15 107N D | RUN | 1 | M11 | Neumático comercialST para trailer; carcasa y compuesto según fabricante. | 49988389.543 | 687.82×203.20×688.08 | Incluido en la línea de compra M11; no sumar precio por cada sólido.
RU-RIM-1--1 | Llanta15×5.5 · cinco agujeros | RUN | 1 | M12 | Llanta de acero comercial para trailer,capacidad mínima recomendada>=975 kg y presión>=65 psi; certificado requerido. | 1746086.908 | 396.00×149.70×396.00 | Incluido en la línea de compra M12; no sumar precio por cada sólido.
RU-STUDNUT-1--1-0 | Espárrago y tuerca cónica de rueda1/2-20 | RUN | 1 | M09 | Espárrago de maza y tuerca de ruedaOEM1/2-20, no intercambiar conM12. | 7249.046 | 22.00×35.00×19.05 | Incluido en la línea de compra M09; no sumar precio por cada sólido.
RU-STUDNUT-1--1-1 | Espárrago y tuerca cónica de rueda1/2-20 | RUN | 1 | M09 | Espárrago de maza y tuerca de ruedaOEM1/2-20, no intercambiar conM12. | 7249.046 | 22.00×35.00×19.05 | Incluido en la línea de compra M09; no sumar precio por cada sólido.
RU-STUDNUT-1--1-2 | Espárrago y tuerca cónica de rueda1/2-20 | RUN | 1 | M09 | Espárrago de maza y tuerca de ruedaOEM1/2-20, no intercambiar conM12. | 7249.046 | 22.00×35.00×19.05 | Incluido en la línea de compra M09; no sumar precio por cada sólido.
RU-STUDNUT-1--1-3 | Espárrago y tuerca cónica de rueda1/2-20 | RUN | 1 | M09 | Espárrago de maza y tuerca de ruedaOEM1/2-20, no intercambiar conM12. | 7249.046 | 22.00×35.00×19.05 | Incluido en la línea de compra M09; no sumar precio por cada sólido.
RU-STUDNUT-1--1-4 | Espárrago y tuerca cónica de rueda1/2-20 | RUN | 1 | M09 | Espárrago de maza y tuerca de ruedaOEM1/2-20, no intercambiar conM12. | 7249.046 | 22.00×35.00×19.05 | Incluido en la línea de compra M09; no sumar precio por cada sólido.
RU-SPINDLE-1-1 | Mangueta escalonada de eje, representación de interfaz | RUN | 1 | M09 | Mangueta forjada/mecanizada de ejeOEM; material y tratamiento no inferidos. | 184458.456 | 53.96×130.00×53.92 | Incluido en la línea de compra M09; no sumar precio por cada sólido.
RU-BACKPLATE-1-1 | Plato portafreno254×57.15 eléctrico con estacionamiento | RUN | 1 | M09 | Conjunto comercial de freno; acero estampado y mecanismosOEM. | 272140.464 | 269.91×5.00×269.82 | Incluido en la línea de compra M09; no sumar precio por cada sólido.
RU-SHOE-1-1-0 | Zapata y forro de freno1 | RUN | 1 | M09 | Forro sin asbesto y acero según frenoOEM; coeficiente no supuesto. | 103782.261 | 229.30×57.15×75.79 | Incluido en la línea de compra M09; no sumar precio por cada sólido.
RU-SHOE-1-1-1 | Zapata y forro de freno2 | RUN | 1 | M09 | Forro sin asbesto y acero según frenoOEM; coeficiente no supuesto. | 103782.261 | 229.30×57.15×75.79 | Incluido en la línea de compra M09; no sumar precio por cada sólido.
RU-MAGNET-1-1 | Imán de freno eléctrico12V y brazo | RUN | 1 | M09 | Conjunto electromagnéticoOEM; forma exterior indicativa. | 50605.672 | 80.77×36.96×181.49 | Incluido en la línea de compra M09; no sumar precio por cada sólido.
RU-DRUM-1-1 | Tambor-maza5×114.3 · conjunto de compra | RUN | 1 | M09 | Tambor-maza de fundición especificada por proveedor, rodamientos y reténOEM. | 1919896.386 | 275.53×154.00×276.00 | Incluido en la línea de compra M09; no sumar precio por cada sólido.
RU-BEARINGS-1-1 | Rodamientos, retén y tapa de maza | RUN | 1 | M09 | Rodamientos de rodillos cónicos y retén de elastómero según manguetaOEM. | 83346.265 | 57.86×90.00×58.00 | Incluido en la línea de compra M09; no sumar precio por cada sólido.
RU-TIRE-1-1 | NeumáticoST205/75R15 107N D | RUN | 1 | M11 | Neumático comercialST para trailer; carcasa y compuesto según fabricante. | 49988389.543 | 687.82×203.20×688.08 | Incluido en la línea de compra M11; no sumar precio por cada sólido.
RU-RIM-1-1 | Llanta15×5.5 · cinco agujeros | RUN | 1 | M12 | Llanta de acero comercial para trailer,capacidad mínima recomendada>=975 kg y presión>=65 psi; certificado requerido. | 1746086.908 | 396.00×149.70×396.00 | Incluido en la línea de compra M12; no sumar precio por cada sólido.
RU-STUDNUT-1-1-0 | Espárrago y tuerca cónica de rueda1/2-20 | RUN | 1 | M09 | Espárrago de maza y tuerca de ruedaOEM1/2-20, no intercambiar conM12. | 7249.046 | 22.00×35.00×19.05 | Incluido en la línea de compra M09; no sumar precio por cada sólido.
RU-STUDNUT-1-1-1 | Espárrago y tuerca cónica de rueda1/2-20 | RUN | 1 | M09 | Espárrago de maza y tuerca de ruedaOEM1/2-20, no intercambiar conM12. | 7249.046 | 22.00×35.00×19.05 | Incluido en la línea de compra M09; no sumar precio por cada sólido.
RU-STUDNUT-1-1-2 | Espárrago y tuerca cónica de rueda1/2-20 | RUN | 1 | M09 | Espárrago de maza y tuerca de ruedaOEM1/2-20, no intercambiar conM12. | 7249.046 | 22.00×35.00×19.05 | Incluido en la línea de compra M09; no sumar precio por cada sólido.
RU-STUDNUT-1-1-3 | Espárrago y tuerca cónica de rueda1/2-20 | RUN | 1 | M09 | Espárrago de maza y tuerca de ruedaOEM1/2-20, no intercambiar conM12. | 7249.046 | 22.00×35.00×19.05 | Incluido en la línea de compra M09; no sumar precio por cada sólido.
RU-STUDNUT-1-1-4 | Espárrago y tuerca cónica de rueda1/2-20 | RUN | 1 | M09 | Espárrago de maza y tuerca de ruedaOEM1/2-20, no intercambiar conM12. | 7249.046 | 22.00×35.00×19.05 | Incluido en la línea de compra M09; no sumar precio por cada sólido.
DR-ARM--1 | Brazo de lanzaA RHS150×60×5 | DRAW | 1 | M03 | Tubo estructural certificado fy>=235 MPa,150×60×5; eje mayor vertical. | 5413337.695 | 2570.12×964.03×150.00 | Incluido en la línea de compra M03; no sumar precio por cada sólido.
DR-TRANSFER--1 | Placa horizontal de transferencia de lanza · e8 | DRAW | 1 | M07 | S235 e8 mm, contorno triangular/trapezoidal de proyecto. | 418000.0 | 550.00×165.00×8.00 | Incluido en la línea de compra M07; no sumar precio por cada sólido.
DR-SIDEFISH--1 | Cartela de transición de lanza · e6 | DRAW | 1 | M07 | AceroS235 e6, unión soldada. | 473700.0 | 450.00×6.00×260.00 | Incluido en la línea de compra M07; no sumar precio por cada sólido.
DR-ARM-1 | Brazo de lanzaA RHS150×60×5 | DRAW | 1 | M03 | Tubo estructural certificado fy>=235 MPa,150×60×5; eje mayor vertical. | 5413337.695 | 2570.12×964.03×150.00 | Incluido en la línea de compra M03; no sumar precio por cada sólido.
DR-TRANSFER-1 | Placa horizontal de transferencia de lanza · e8 | DRAW | 1 | M07 | S235 e8 mm, contorno triangular/trapezoidal de proyecto. | 418000.0 | 550.00×165.00×8.00 | Incluido en la línea de compra M07; no sumar precio por cada sólido.
DR-SIDEFISH-1 | Cartela de transición de lanza · e6 | DRAW | 1 | M07 | AceroS235 e6, unión soldada. | 473700.0 | 450.00×6.00×260.00 | Incluido en la línea de compra M07; no sumar precio por cada sólido.
DR-BRACE | Travesaño de arriostramiento de lanza60×40×3 | DRAW | 1 | M04 | RHS60×40×3 certificado. | 517405.485 | 40.00×928.00×60.00 | Incluido en la línea de compra M04; no sumar precio por cada sólido.
DR-NOSEPLATE | Placa mecanizada de cabezal ·350×300×10 | DRAW | 1 | M07 | AceroS235 e10; patrón184×54 y agujeros12.5 mm. | 1045091.261 | 350.00×300.00×10.00 | Incluido en la línea de compra M07; no sumar precio por cada sólido.
DR-COUPLING | Cabezal fijo50 mm · referencia614010PL | DRAW | 1 | M19 | Cabezal comercial3500kg de fundición según referencia; no fabricar desdeCAD. | 994734.326 | 382.88×88.00×77.00 | Incluido en la línea de compra M19; no sumar precio por cada sólido.
DR-LATCH | Palanca y pestillo de seguridad del cabezal | DRAW | 1 | M19 | Piezas integrantes del cabezal comercial. | 47391.029 | 169.96×60.00×49.91 | Incluido en la línea de compra M19; no sumar precio por cada sólido.
DR-BOLT--1462--27 | Fijación de cabezalM12 clase8.8 | DRAW | 1 | M23 | M12x1.75 clase8.8 + tuerca8/arandelas; largo provisional50, verificarespesorreal. | 11126.129 | 24.00×23.93×56.00 | Incluido en la línea de compra M23; no sumar precio por cada sólido.
DR-BOLT--1462-27 | Fijación de cabezalM12 clase8.8 | DRAW | 1 | M23 | M12x1.75 clase8.8 + tuerca8/arandelas; largo provisional50, verificarespesorreal. | 11126.129 | 24.00×23.93×56.00 | Incluido en la línea de compra M23; no sumar precio por cada sólido.
DR-BOLT--1278--27 | Fijación de cabezalM12 clase8.8 | DRAW | 1 | M23 | M12x1.75 clase8.8 + tuerca8/arandelas; largo provisional50, verificarespesorreal. | 11126.129 | 24.00×23.93×56.00 | Incluido en la línea de compra M23; no sumar precio por cada sólido.
DR-BOLT--1278-27 | Fijación de cabezalM12 clase8.8 | DRAW | 1 | M23 | M12x1.75 clase8.8 + tuerca8/arandelas; largo provisional50, verificarespesorreal. | 11126.129 | 24.00×23.93×56.00 | Incluido en la línea de compra M23; no sumar precio por cada sólido.
DR-PARKLEVER | Freno de estacionamiento · palanca y tensor | DRAW | 1 | M19 | Mecanismo de cabezal y tensor comercial compatible con frenos de estacionamiento. | 119218.081 | 190.00×60.00×263.98 | Incluido en la línea de compra M19; no sumar precio por cada sólido.
DR-CHAINANCHOR--1 | Anclaje independiente de cadena de seguridad | DRAW | 1 | M07 | PlacaS235 e10 y grillete/cadena certificados por fabricante para masa remolcada2000kg. | 54591.261 | 85.00×10.00×70.00 | Incluido en la línea de compra M07; no sumar precio por cada sólido.
DR-CHAIN--1 | Cadena de seguridad articulada, geometría de representación | DRAW | 1 | M20 | Cadena de seguridad comercial certificada, calibre de representación7mm. | 43524.955 | 370.77×216.95×99.24 | Incluido en la línea de compra M20; no sumar precio por cada sólido.
DR-CHAINANCHOR-1 | Anclaje independiente de cadena de seguridad | DRAW | 1 | M07 | PlacaS235 e10 y grillete/cadena certificados por fabricante para masa remolcada2000kg. | 54591.261 | 85.00×10.00×70.00 | Incluido en la línea de compra M07; no sumar precio por cada sólido.
DR-CHAIN-1 | Cadena de seguridad articulada, geometría de representación | DRAW | 1 | M20 | Cadena de seguridad comercial certificada, calibre de representación7mm. | 43524.955 | 370.77×216.95×99.24 | Incluido en la línea de compra M20; no sumar precio por cada sólido.
DR-JOCKEYCLAMP | Abrazadera atornillada de rueda jockey | DRAW | 1 | M21 | Abrazadera comercial compatible con tuboØ60;placaS235 en adaptador. | 487189.424 | 100.00×80.98×100.00 | Incluido en la línea de compra M21; no sumar precio por cada sólido.
DR-JOCKEYTUBE | Jockey telescópicaØ60, manivela y bloqueo | DRAW | 1 | M21 | Conjunto telescópico comercial galvanizado; husillo interno no representado. | 492915.887 | 122.00×60.00×395.00 | Incluido en la línea de compra M21; no sumar precio por cada sólido.
DR-JOCKEYWHEEL | Rueda y horquilla jockeyØ200 | DRAW | 1 | M21 | Rueda de caucho macizo y horquilla de compra. | 2076371.519 | 199.92×100.00×199.84 | Incluido en la línea de compra M21; no sumar precio por cada sólido.
SU-THRUST--1-0-SPR--1 | Arandela de empuje de gemela e2 | SUSP | 1 | M14 | Arandela de empuje del kit, e2 de representación. | 896.673 | 28.00×2.00×28.00 | Incluido en la línea de compra M14; no sumar precio por cada sólido.
SU-THRUST--1-0-SPR-1 | Arandela de empuje de gemela e2 | SUSP | 1 | M14 | Arandela de empuje del kit, e2 de representación. | 896.673 | 28.00×2.00×28.00 | Incluido en la línea de compra M14; no sumar precio por cada sólido.
SU-THRUST--1-0-EQ--1 | Arandela de empuje de gemela e2 | SUSP | 1 | M14 | Arandela de empuje del kit, e2 de representación. | 896.673 | 28.00×2.00×28.00 | Incluido en la línea de compra M14; no sumar precio por cada sólido.
SU-THRUST--1-0-EQ-1 | Arandela de empuje de gemela e2 | SUSP | 1 | M14 | Arandela de empuje del kit, e2 de representación. | 896.673 | 28.00×2.00×28.00 | Incluido en la línea de compra M14; no sumar precio por cada sólido.
SU-BUMPBR--1-0 | Soporte atornillado de tope de compresión | SUSP | 1 | M07 | S235 e6; no colgar de piso ni de guardabarro. | 103200.0 | 80.00×115.00×106.00 | Incluido en la línea de compra M07; no sumar precio por cada sólido.
SU-BUMP--1-0 | Tope elastomérico de compresión · reserva70 mm | SUSP | 1 | M18 | Elastómero progresivo de proveedor; forma de representación70×70. | 532675.284 | 70.00×70.00×108.71 | Incluido en la línea de compra M18; no sumar precio por cada sólido.
SU-THRUST--1-1-SPR--1 | Arandela de empuje de gemela e2 | SUSP | 1 | M14 | Arandela de empuje del kit, e2 de representación. | 896.673 | 28.00×2.00×28.00 | Incluido en la línea de compra M14; no sumar precio por cada sólido.
SU-THRUST--1-1-SPR-1 | Arandela de empuje de gemela e2 | SUSP | 1 | M14 | Arandela de empuje del kit, e2 de representación. | 896.673 | 28.00×2.00×28.00 | Incluido en la línea de compra M14; no sumar precio por cada sólido.
SU-THRUST--1-1-EQ--1 | Arandela de empuje de gemela e2 | SUSP | 1 | M14 | Arandela de empuje del kit, e2 de representación. | 896.673 | 28.00×2.00×28.00 | Incluido en la línea de compra M14; no sumar precio por cada sólido.
SU-THRUST--1-1-EQ-1 | Arandela de empuje de gemela e2 | SUSP | 1 | M14 | Arandela de empuje del kit, e2 de representación. | 896.673 | 28.00×2.00×28.00 | Incluido en la línea de compra M14; no sumar precio por cada sólido.
SU-BUMPBR--1-1 | Soporte atornillado de tope de compresión | SUSP | 1 | M07 | S235 e6; no colgar de piso ni de guardabarro. | 103200.0 | 80.00×115.00×106.00 | Incluido en la línea de compra M07; no sumar precio por cada sólido.
SU-BUMP--1-1 | Tope elastomérico de compresión · reserva70 mm | SUSP | 1 | M18 | Elastómero progresivo de proveedor; forma de representación70×70. | 532675.284 | 70.00×70.00×108.71 | Incluido en la línea de compra M18; no sumar precio por cada sólido.
SU-THRUST-1-0-SPR--1 | Arandela de empuje de gemela e2 | SUSP | 1 | M14 | Arandela de empuje del kit, e2 de representación. | 896.673 | 28.00×2.00×28.00 | Incluido en la línea de compra M14; no sumar precio por cada sólido.
SU-THRUST-1-0-SPR-1 | Arandela de empuje de gemela e2 | SUSP | 1 | M14 | Arandela de empuje del kit, e2 de representación. | 896.673 | 28.00×2.00×28.00 | Incluido en la línea de compra M14; no sumar precio por cada sólido.
SU-THRUST-1-0-EQ--1 | Arandela de empuje de gemela e2 | SUSP | 1 | M14 | Arandela de empuje del kit, e2 de representación. | 896.673 | 28.00×2.00×28.00 | Incluido en la línea de compra M14; no sumar precio por cada sólido.
SU-THRUST-1-0-EQ-1 | Arandela de empuje de gemela e2 | SUSP | 1 | M14 | Arandela de empuje del kit, e2 de representación. | 896.673 | 28.00×2.00×28.00 | Incluido en la línea de compra M14; no sumar precio por cada sólido.
SU-BUMPBR-1-0 | Soporte atornillado de tope de compresión | SUSP | 1 | M07 | S235 e6; no colgar de piso ni de guardabarro. | 103200.0 | 80.00×115.00×106.00 | Incluido en la línea de compra M07; no sumar precio por cada sólido.
SU-BUMP-1-0 | Tope elastomérico de compresión · reserva70 mm | SUSP | 1 | M18 | Elastómero progresivo de proveedor; forma de representación70×70. | 532675.284 | 70.00×70.00×108.71 | Incluido en la línea de compra M18; no sumar precio por cada sólido.
SU-THRUST-1-1-SPR--1 | Arandela de empuje de gemela e2 | SUSP | 1 | M14 | Arandela de empuje del kit, e2 de representación. | 896.673 | 28.00×2.00×28.00 | Incluido en la línea de compra M14; no sumar precio por cada sólido.
SU-THRUST-1-1-SPR-1 | Arandela de empuje de gemela e2 | SUSP | 1 | M14 | Arandela de empuje del kit, e2 de representación. | 896.673 | 28.00×2.00×28.00 | Incluido en la línea de compra M14; no sumar precio por cada sólido.
SU-THRUST-1-1-EQ--1 | Arandela de empuje de gemela e2 | SUSP | 1 | M14 | Arandela de empuje del kit, e2 de representación. | 896.673 | 28.00×2.00×28.00 | Incluido en la línea de compra M14; no sumar precio por cada sólido.
SU-THRUST-1-1-EQ-1 | Arandela de empuje de gemela e2 | SUSP | 1 | M14 | Arandela de empuje del kit, e2 de representación. | 896.673 | 28.00×2.00×28.00 | Incluido en la línea de compra M14; no sumar precio por cada sólido.
SU-BUMPBR-1-1 | Soporte atornillado de tope de compresión | SUSP | 1 | M07 | S235 e6; no colgar de piso ni de guardabarro. | 103200.0 | 80.00×115.00×106.00 | Incluido en la línea de compra M07; no sumar precio por cada sólido.
SU-BUMP-1-1 | Tope elastomérico de compresión · reserva70 mm | SUSP | 1 | M18 | Elastómero progresivo de proveedor; forma de representación70×70. | 532675.284 | 70.00×70.00×108.71 | Incluido en la línea de compra M18; no sumar precio por cada sólido.
BO-FENDER--1 | Guardabarros tándem plegado · chapa2 | BODY | 1 | M08 | Chapa de acero galvanizada e2 o aluminio equivalente redimensionado; aislar metales distintos. | 1076608.0 | 1680.00×260.00×330.00 | Incluido en la línea de compra M08; no sumar precio por cada sólido.
BO-FENDERSKIRT--1 | Faldón exterior de guardabarro e2 | BODY | 1 | M08 | Chapa e2 con dobladillo/redondeo de arista en plano definitivo. | 268800.0 | 1680.00×2.00×410.00 | Incluido en la línea de compra M08; no sumar precio por cada sólido.
BO-FENDERBR--1-0 | Ménsula diagonal frontal de guardabarro | BODY | 1 | M07 | MénsulaS235 e5; tornillosM8 clase8.8 y arandelas de reparto. | 48950.0 | 122.00×145.00×135.00 | Incluido en la línea de compra M07; no sumar precio por cada sólido.
BO-FENDERBR--1-1 | Ménsula de guardabarro con agujeros M8 | BODY | 1 | M07 | MénsulaS235 e5; tornillosM8 clase8.8 y arandelas de reparto. | 127363.827 | 80.00×197.50×120.00 | Incluido en la línea de compra M07; no sumar precio por cada sólido.
BO-FENDERBR--1-2 | Ménsula diagonal trasera de guardabarro | BODY | 1 | M07 | MénsulaS235 e5; tornillosM8 clase8.8 y arandelas de reparto. | 48950.0 | 122.00×145.00×135.00 | Incluido en la línea de compra M07; no sumar precio por cada sólido.
BO-FENDER-1 | Guardabarros tándem plegado · chapa2 | BODY | 1 | M08 | Chapa de acero galvanizada e2 o aluminio equivalente redimensionado; aislar metales distintos. | 1076608.0 | 1680.00×260.00×330.00 | Incluido en la línea de compra M08; no sumar precio por cada sólido.
BO-FENDERSKIRT-1 | Faldón exterior de guardabarro e2 | BODY | 1 | M08 | Chapa e2 con dobladillo/redondeo de arista en plano definitivo. | 268800.0 | 1680.00×2.00×410.00 | Incluido en la línea de compra M08; no sumar precio por cada sólido.
BO-FENDERBR-1-0 | Ménsula diagonal frontal de guardabarro | BODY | 1 | M07 | MénsulaS235 e5; tornillosM8 clase8.8 y arandelas de reparto. | 48950.0 | 122.00×145.00×135.00 | Incluido en la línea de compra M07; no sumar precio por cada sólido.
BO-FENDERBR-1-1 | Ménsula de guardabarro con agujeros M8 | BODY | 1 | M07 | MénsulaS235 e5; tornillosM8 clase8.8 y arandelas de reparto. | 127363.827 | 80.00×197.50×120.00 | Incluido en la línea de compra M07; no sumar precio por cada sólido.
BO-FENDERBR-1-2 | Ménsula diagonal trasera de guardabarro | BODY | 1 | M07 | MénsulaS235 e5; tornillosM8 clase8.8 y arandelas de reparto. | 48950.0 | 122.00×145.00×135.00 | Incluido en la línea de compra M07; no sumar precio por cada sólido.
BO-STEADY--1-0 | Estabilizador de esquina retraído · conjunto mecánico | BODY | 1 | M22 | Componente de compra galvanizado con capacidad deestabilización>=500kg porapoyo, a confirmar. | 329882.599 | 200.00×100.00×142.00 | Incluido en la línea de compra M22; no sumar precio por cada sólido.
BO-STEADY--1-1 | Estabilizador de esquina retraído · conjunto mecánico | BODY | 1 | M22 | Componente de compra galvanizado con capacidad deestabilización>=500kg porapoyo, a confirmar. | 329882.599 | 200.00×100.00×142.00 | Incluido en la línea de compra M22; no sumar precio por cada sólido.
BO-STEADY-1-0 | Estabilizador de esquina retraído · conjunto mecánico | BODY | 1 | M22 | Componente de compra galvanizado con capacidad deestabilización>=500kg porapoyo, a confirmar. | 329882.599 | 200.00×100.00×142.00 | Incluido en la línea de compra M22; no sumar precio por cada sólido.
BO-STEADY-1-1 | Estabilizador de esquina retraído · conjunto mecánico | BODY | 1 | M22 | Componente de compra galvanizado con capacidad deestabilización>=500kg porapoyo, a confirmar. | 329882.599 | 200.00×100.00×142.00 | Incluido en la línea de compra M22; no sumar precio por cada sólido.
BO-BUMPER | Travesaño posterior y soporte de señalización | BODY | 1 | M06 | RHS80×60×3 certificado y ménsulasS235. | 1608000.0 | 60.00×2000.00×80.00 | Incluido en la línea de compra M06; no sumar precio por cada sólido.
BO-BUMPERBR--1 | Brazo de fijación de travesaño posterior | BODY | 1 | M07 | S235 e6, dosporconjunto. | 79200.0 | 220.00×60.00×6.00 | Incluido en la línea de compra M07; no sumar precio por cada sólido.
EL-TAILLAMP--1 | Óptica posterior: posición, freno, giro y reversa | ELEC | 1 | M28 | ÓpticaLED comercial certificada para funciones yposición requeridas. | 468100.0 | 31.00×190.00×85.00 | Incluido en la línea de compra M28; no sumar precio por cada sólido.
EL-REFLECTOR--1 | Catadióptrico trasero triangular rojo | ELEC | 1 | M30 | Catadióptrico comercial certificado; geometría triangularindicativa. | 19800.0 | 4.00×110.00×90.00 | Incluido en la línea de compra M30; no sumar precio por cada sólido.
EL-SIDELAMP--1-0 | Marcador lateral ámbar y soporte | ELEC | 1 | M29 | MarcadorLEDcomercial ycatadióptrico segúnnormativalocal. | 19500.0 | 65.00×10.00×30.00 | Incluido en la línea de compra M29; no sumar precio por cada sólido.
EL-SIDELAMP--1-1 | Marcador lateral ámbar y soporte | ELEC | 1 | M29 | MarcadorLEDcomercial ycatadióptrico segúnnormativalocal. | 19500.0 | 65.00×10.00×30.00 | Incluido en la línea de compra M29; no sumar precio por cada sólido.
EL-SIDELAMP--1-2 | Marcador lateral ámbar y soporte | ELEC | 1 | M29 | MarcadorLEDcomercial ycatadióptrico segúnnormativalocal. | 19500.0 | 65.00×10.00×30.00 | Incluido en la línea de compra M29; no sumar precio por cada sólido.
BO-BUMPERBR-1 | Brazo de fijación de travesaño posterior | BODY | 1 | M07 | S235 e6, dosporconjunto. | 79200.0 | 220.00×60.00×6.00 | Incluido en la línea de compra M07; no sumar precio por cada sólido.
EL-TAILLAMP-1 | Óptica posterior: posición, freno, giro y reversa | ELEC | 1 | M28 | ÓpticaLED comercial certificada para funciones yposición requeridas. | 468100.0 | 31.00×190.00×85.00 | Incluido en la línea de compra M28; no sumar precio por cada sólido.
EL-REFLECTOR-1 | Catadióptrico trasero triangular rojo | ELEC | 1 | M30 | Catadióptrico comercial certificado; geometría triangularindicativa. | 19800.0 | 4.00×110.00×90.00 | Incluido en la línea de compra M30; no sumar precio por cada sólido.
EL-SIDELAMP-1-0 | Marcador lateral ámbar y soporte | ELEC | 1 | M29 | MarcadorLEDcomercial ycatadióptrico segúnnormativalocal. | 19500.0 | 65.00×10.00×30.00 | Incluido en la línea de compra M29; no sumar precio por cada sólido.
EL-SIDELAMP-1-1 | Marcador lateral ámbar y soporte | ELEC | 1 | M29 | MarcadorLEDcomercial ycatadióptrico segúnnormativalocal. | 19500.0 | 65.00×10.00×30.00 | Incluido en la línea de compra M29; no sumar precio por cada sólido.
EL-SIDELAMP-1-2 | Marcador lateral ámbar y soporte | ELEC | 1 | M29 | MarcadorLEDcomercial ycatadióptrico segúnnormativalocal. | 19500.0 | 65.00×10.00×30.00 | Incluido en la línea de compra M29; no sumar precio por cada sólido.
EL-PLATE | Portapatente con iluminación blanca | ELEC | 1 | M31 | Chapa protegida y luzdepatentecomercial. | 340800.0 | 31.00×540.00×150.00 | Incluido en la línea de compra M31; no sumar precio por cada sólido.
EL-BOX | Caja de distribución estanca y batería de ruptura | ELEC | 1 | M27 | CajaIP67 de compra ybatería12V7Ah de referencia; capacidad yretencióndebenseleccionarseconkitbreakaway. | 7308310.0 | 246.00×186.00×150.00 | Incluido en la línea de compra M27; no sumar precio por cada sólido.
EL-BREAKAWAY | Interruptor de ruptura y cable independiente | ELEC | 1 | M27 | Kitbreakaway certificado compatible12V4frenos. | 70050.708 | 460.19×63.49×39.49 | Incluido en la línea de compra M27; no sumar precio por cada sólido.
EL-HARNESS | Mazo protegido sobre larguero y cuatro lazos de servicio | ELEC | 1 | M32 | Principal2×6mm²cobreautomotriz,ramales2×2.5mm²; camisa,prensaestopas yconectores para ambientevial. | 913696.547 | 5481.87×2007.94×254.50 | Incluido en la línea de compra M32; no sumar precio por cada sólido.
EL-PARKCABLE | Estacionamiento: repartidor y cuatro fundas Bowden | ELEC | 1 | M25 | CablesBowden/fundas de freno delproveedor,compensadoresytensorescomerciales. | 715405.143 | 4418.90×2017.66×149.75 | Incluido en la línea de compra M25; no sumar precio por cada sólido.
SU-DAMPER-0--1 | Amortiguador de referencia dimensional283271 · reubicado S01 | SUSP | 1 | M17 | Amortiguador comercial; envolvente de desarrollo. Referencia dimensional Lippert283271. No fabricar el componente con este CAD. | 218661.934 | 197.42×43.89×243.43 | Incluido en la línea de compra M17; no sumar precio por cada sólido.
SU-DAMPERLOW-0--1 | Ménsula inferior continua fuera del eje y ballesta · S01 | SUSP | 1 | M07 | Alma de chapaS235 e8 y asiento anularØ56/e6, agujeroØ12. Desarrollo propio; no accesorio OEM aprobado. | 50145.718 | 47.44×112.99×158.04 | Incluido en la línea de compra M07; no sumar precio por cada sólido.
SU-DAMPERUP-0--1 | Ménsula superior continua con despeje de gomas · S01 | SUSP | 1 | M07 | Chapa S235: base100 ×175 ×6, dos nervios e6 y asientoØ56/e6 con agujeroØ12. Espesores de desarrollo sujetos a cálculo. | 172589.979 | 100.00×183.00×89.87 | Incluido en la línea de compra M07; no sumar precio por cada sólido.
SU-DAMPER-0-1 | Amortiguador de referencia dimensional283271 · reubicado S01 | SUSP | 1 | M17 | Amortiguador comercial; envolvente de desarrollo. Referencia dimensional Lippert283271. No fabricar el componente con este CAD. | 218661.934 | 197.42×43.89×243.43 | Incluido en la línea de compra M17; no sumar precio por cada sólido.
SU-DAMPERLOW-0-1 | Ménsula inferior continua fuera del eje y ballesta · S01 | SUSP | 1 | M07 | Alma de chapaS235 e8 y asiento anularØ56/e6, agujeroØ12. Desarrollo propio; no accesorio OEM aprobado. | 50145.718 | 47.44×112.99×158.04 | Incluido en la línea de compra M07; no sumar precio por cada sólido.
SU-DAMPERUP-0-1 | Ménsula superior continua con despeje de gomas · S01 | SUSP | 1 | M07 | Chapa S235: base100 ×175 ×6, dos nervios e6 y asientoØ56/e6 con agujeroØ12. Espesores de desarrollo sujetos a cálculo. | 172589.979 | 100.00×183.00×89.87 | Incluido en la línea de compra M07; no sumar precio por cada sólido.
SU-DAMPER-1--1 | Amortiguador de referencia dimensional283271 · reubicado S01 | SUSP | 1 | M17 | Amortiguador comercial; envolvente de desarrollo. Referencia dimensional Lippert283271. No fabricar el componente con este CAD. | 218661.934 | 197.42×43.89×243.43 | Incluido en la línea de compra M17; no sumar precio por cada sólido.
SU-DAMPERLOW-1--1 | Ménsula inferior continua fuera del eje y ballesta · S01 | SUSP | 1 | M07 | Alma de chapaS235 e8 y asiento anularØ56/e6, agujeroØ12. Desarrollo propio; no accesorio OEM aprobado. | 50145.718 | 47.44×112.99×158.04 | Incluido en la línea de compra M07; no sumar precio por cada sólido.
SU-DAMPERUP-1--1 | Ménsula superior continua con despeje de gomas · S01 | SUSP | 1 | M07 | Chapa S235: base100 ×175 ×6, dos nervios e6 y asientoØ56/e6 con agujeroØ12. Espesores de desarrollo sujetos a cálculo. | 172589.979 | 100.00×183.00×89.87 | Incluido en la línea de compra M07; no sumar precio por cada sólido.
SU-DAMPER-1-1 | Amortiguador de referencia dimensional283271 · reubicado S01 | SUSP | 1 | M17 | Amortiguador comercial; envolvente de desarrollo. Referencia dimensional Lippert283271. No fabricar el componente con este CAD. | 218661.934 | 197.42×43.89×243.43 | Incluido en la línea de compra M17; no sumar precio por cada sólido.
SU-DAMPERLOW-1-1 | Ménsula inferior continua fuera del eje y ballesta · S01 | SUSP | 1 | M07 | Alma de chapaS235 e8 y asiento anularØ56/e6, agujeroØ12. Desarrollo propio; no accesorio OEM aprobado. | 50145.718 | 47.44×112.99×158.04 | Incluido en la línea de compra M07; no sumar precio por cada sólido.
SU-DAMPERUP-1-1 | Ménsula superior continua con despeje de gomas · S01 | SUSP | 1 | M07 | Chapa S235: base100 ×175 ×6, dos nervios e6 y asientoØ56/e6 con agujeroØ12. Espesores de desarrollo sujetos a cálculo. | 172589.979 | 100.00×183.00×89.87 | Incluido en la línea de compra M07; no sumar precio por cada sólido.
FR-HANGERBRIDGE-0 | Puente transversal de colgantes · estación 1890.7 | FRAME | 1 | M07 | Canal conformado S235 C75 × 40 × 4, abierto para inspección. | 1128000.2 | 40.00×1867.55×75.00 | Incluido en la línea de compra M07; no sumar precio por cada sólido.
FR-HANGERBRIDGE-1 | Puente transversal de colgantes · estación 2640 | FRAME | 1 | M07 | Canal conformado S235 C75 × 40 × 4, abierto para inspección. | 1128000.2 | 40.00×1867.55×75.00 | Incluido en la línea de compra M07; no sumar precio por cada sólido.
FR-HANGERBRIDGE-2 | Puente transversal de colgantes · estación 3389.3 | FRAME | 1 | M07 | Canal conformado S235 C75 × 40 × 4, abierto para inspección. | 1128000.2 | 40.00×1867.55×75.00 | Incluido en la línea de compra M07; no sumar precio por cada sólido.
SU-DAMPERKIT-0--1 | Cuatro gomas, cuatro arandelas y dos tuercas · S01 | SUSP | 1 | M17 | Gomas y arandelas del amortiguador comercial; dimensiones de interfaz ilustrativas. Tuercas3/8-24 de referencia a confirmar con proveedor; roscas no modeladas. | 25372.615 | 201.18×31.98×241.72 | Incluido en la línea de compra M17; no sumar precio por cada sólido.
SU-DAMPERKIT-0-1 | Cuatro gomas, cuatro arandelas y dos tuercas · S01 | SUSP | 1 | M17 | Gomas y arandelas del amortiguador comercial; dimensiones de interfaz ilustrativas. Tuercas3/8-24 de referencia a confirmar con proveedor; roscas no modeladas. | 25372.615 | 201.18×31.98×241.72 | Incluido en la línea de compra M17; no sumar precio por cada sólido.
SU-DAMPERKIT-1--1 | Cuatro gomas, cuatro arandelas y dos tuercas · S01 | SUSP | 1 | M17 | Gomas y arandelas del amortiguador comercial; dimensiones de interfaz ilustrativas. Tuercas3/8-24 de referencia a confirmar con proveedor; roscas no modeladas. | 25372.615 | 201.18×31.98×241.72 | Incluido en la línea de compra M17; no sumar precio por cada sólido.
SU-DAMPERKIT-1-1 | Cuatro gomas, cuatro arandelas y dos tuercas · S01 | SUSP | 1 | M17 | Gomas y arandelas del amortiguador comercial; dimensiones de interfaz ilustrativas. Tuercas3/8-24 de referencia a confirmar con proveedor; roscas no modeladas. | 25372.615 | 201.18×31.98×241.72 | Incluido en la línea de compra M17; no sumar precio por cada sólido.
BO-BODYMOUNT-0 | Anclaje de piso M10 con separador y contraplaca | BODY | 1 | M24 | M10 clase8.8, contraplaca acero70 ×60 ×3; casquillo Ø16/11 L30; interfaz EPDM3 nominal. | 34844.27 | 70.00×60.00×59.40 | Incluido en la línea de compra M24; no sumar precio por cada sólido.
BO-BODYMOUNT-1 | Anclaje de piso M10 con separador y contraplaca | BODY | 1 | M24 | M10 clase8.8, contraplaca acero70 ×60 ×3; casquillo Ø16/11 L30; interfaz EPDM3 nominal. | 34844.27 | 70.00×60.00×59.40 | Incluido en la línea de compra M24; no sumar precio por cada sólido.
BO-BODYMOUNT-2 | Anclaje de piso M10 con separador y contraplaca | BODY | 1 | M24 | M10 clase8.8, contraplaca acero70 ×60 ×3; casquillo Ø16/11 L30; interfaz EPDM3 nominal. | 34844.27 | 70.00×60.00×59.40 | Incluido en la línea de compra M24; no sumar precio por cada sólido.
BO-BODYMOUNT-3 | Anclaje de piso M10 con separador y contraplaca | BODY | 1 | M24 | M10 clase8.8, contraplaca acero70 ×60 ×3; casquillo Ø16/11 L30; interfaz EPDM3 nominal. | 34844.27 | 70.00×60.00×59.40 | Incluido en la línea de compra M24; no sumar precio por cada sólido.
BO-BODYMOUNT-4 | Anclaje de piso M10 con separador y contraplaca | BODY | 1 | M24 | M10 clase8.8, contraplaca acero70 ×60 ×3; casquillo Ø16/11 L30; interfaz EPDM3 nominal. | 34844.27 | 70.00×60.00×59.40 | Incluido en la línea de compra M24; no sumar precio por cada sólido.
BO-BODYMOUNT-5 | Anclaje de piso M10 con separador y contraplaca | BODY | 1 | M24 | M10 clase8.8, contraplaca acero70 ×60 ×3; casquillo Ø16/11 L30; interfaz EPDM3 nominal. | 34844.27 | 70.00×60.00×59.40 | Incluido en la línea de compra M24; no sumar precio por cada sólido.
BO-BODYMOUNT-6 | Anclaje de piso M10 con separador y contraplaca | BODY | 1 | M24 | M10 clase8.8, contraplaca acero70 ×60 ×3; casquillo Ø16/11 L30; interfaz EPDM3 nominal. | 34844.27 | 70.00×60.00×59.40 | Incluido en la línea de compra M24; no sumar precio por cada sólido.
BO-BODYMOUNT-7 | Anclaje de piso M10 con separador y contraplaca | BODY | 1 | M24 | M10 clase8.8, contraplaca acero70 ×60 ×3; casquillo Ø16/11 L30; interfaz EPDM3 nominal. | 34844.27 | 70.00×60.00×59.40 | Incluido en la línea de compra M24; no sumar precio por cada sólido.
BO-BODYMOUNT-8 | Anclaje de piso M10 con separador y contraplaca | BODY | 1 | M24 | M10 clase8.8, contraplaca acero70 ×60 ×3; casquillo Ø16/11 L30; interfaz EPDM3 nominal. | 34844.27 | 70.00×60.00×59.40 | Incluido en la línea de compra M24; no sumar precio por cada sólido.
BO-BODYMOUNT-9 | Anclaje de piso M10 con separador y contraplaca | BODY | 1 | M24 | M10 clase8.8, contraplaca acero70 ×60 ×3; casquillo Ø16/11 L30; interfaz EPDM3 nominal. | 34844.27 | 70.00×60.00×59.40 | Incluido en la línea de compra M24; no sumar precio por cada sólido.
EL-CLIP-0 | Presilla aislada y soporte de mazo · paso400 | ELEC | 1 | M33 | Presilla P aislada y oreja auxiliar de acero2 mm. M5 sólo representativo. | 3032.218 | 20.00×34.99×19.98 | Incluido en la línea de compra M33; no sumar precio por cada sólido.
EL-CLIP-1 | Presilla aislada y soporte de mazo · paso400 | ELEC | 1 | M33 | Presilla P aislada y oreja auxiliar de acero2 mm. M5 sólo representativo. | 3032.218 | 20.00×34.99×19.98 | Incluido en la línea de compra M33; no sumar precio por cada sólido.
EL-CLIP-2 | Presilla aislada y soporte de mazo · paso400 | ELEC | 1 | M33 | Presilla P aislada y oreja auxiliar de acero2 mm. M5 sólo representativo. | 3032.218 | 20.00×34.99×19.98 | Incluido en la línea de compra M33; no sumar precio por cada sólido.
EL-CLIP-3 | Presilla aislada y soporte de mazo · paso400 | ELEC | 1 | M33 | Presilla P aislada y oreja auxiliar de acero2 mm. M5 sólo representativo. | 3032.218 | 20.00×34.99×19.98 | Incluido en la línea de compra M33; no sumar precio por cada sólido.
EL-CLIP-4 | Presilla aislada y soporte de mazo · paso400 | ELEC | 1 | M33 | Presilla P aislada y oreja auxiliar de acero2 mm. M5 sólo representativo. | 3032.218 | 20.00×34.99×19.98 | Incluido en la línea de compra M33; no sumar precio por cada sólido.
EL-CLIP-5 | Presilla aislada y soporte de mazo · paso400 | ELEC | 1 | M33 | Presilla P aislada y oreja auxiliar de acero2 mm. M5 sólo representativo. | 3032.218 | 20.00×34.99×19.98 | Incluido en la línea de compra M33; no sumar precio por cada sólido.
EL-CLIP-6 | Presilla aislada y soporte de mazo · paso400 | ELEC | 1 | M33 | Presilla P aislada y oreja auxiliar de acero2 mm. M5 sólo representativo. | 3032.218 | 20.00×34.99×19.98 | Incluido en la línea de compra M33; no sumar precio por cada sólido.
EL-CLIP-7 | Presilla aislada y soporte de mazo · paso400 | ELEC | 1 | M33 | Presilla P aislada y oreja auxiliar de acero2 mm. M5 sólo representativo. | 3032.218 | 20.00×34.99×19.98 | Incluido en la línea de compra M33; no sumar precio por cada sólido.
EL-CLIP-8 | Presilla aislada y soporte de mazo · paso400 | ELEC | 1 | M33 | Presilla P aislada y oreja auxiliar de acero2 mm. M5 sólo representativo. | 3032.218 | 20.00×34.99×19.98 | Incluido en la línea de compra M33; no sumar precio por cada sólido.
EL-CLIP-9 | Presilla aislada y soporte de mazo · paso400 | ELEC | 1 | M33 | Presilla P aislada y oreja auxiliar de acero2 mm. M5 sólo representativo. | 3032.218 | 20.00×34.99×19.98 | Incluido en la línea de compra M33; no sumar precio por cada sólido.
EL-CLIP-10 | Presilla aislada y soporte de mazo · paso400 | ELEC | 1 | M33 | Presilla P aislada y oreja auxiliar de acero2 mm. M5 sólo representativo. | 3032.218 | 20.00×34.99×19.98 | Incluido en la línea de compra M33; no sumar precio por cada sólido.
EL-JUNCTION-0 | Caja de derivación de frenos y alivio de tracción | ELEC | 1 | M34 | Caja comercial estanca objetivoIP67, prensaestopas y conectores sellados de automoción; grado IP por certificado de producto. | 97758.017 | 90.00×88.00×41.00 | Incluido en la línea de compra M34; no sumar precio por cada sólido.
EL-JUNCTION-1 | Caja de derivación de frenos y alivio de tracción | ELEC | 1 | M34 | Caja comercial estanca objetivoIP67, prensaestopas y conectores sellados de automoción; grado IP por certificado de producto. | 97758.017 | 90.00×88.00×41.00 | Incluido en la línea de compra M34; no sumar precio por cada sólido.
EL-BOWDENANCHOR--1 | Soporte fijo de fundas Bowden con ajuste doble | ELEC | 1 | M07 | S235 | 150215.353 | 57.00×80.00×110.00 | Incluido en la línea de compra M07; no sumar precio por cada sólido.
EL-BOWDENANCHOR-1 | Soporte fijo de fundas Bowden con ajuste doble | ELEC | 1 | M07 | S235 | 150215.353 | 57.00×80.00×110.00 | Incluido en la línea de compra M07; no sumar precio por cada sólido.
FR-PARKCROSS | Travesaño auxiliar para reacción del estacionamiento | FRAME | 1 | M05 | S235 | 821400.0 | 40.00×1850.00×40.00 | Incluido en la línea de compra M05; no sumar precio por cada sólido.
DR-JOCKEYBRACE | Puente de fijación de abrazadera jockey a brazo izquierdo | DRAW | 1 | M07 | Chapa8 S235; consola de adaptación para abrazaderaØ60; componente de desarrollo. | 190800.0 | 120.00×38.00×110.00 | Incluido en la línea de compra M07; no sumar precio por cada sólido.
