Felipe-klz/cr200-explorador/downloads/presupuesto-detallado.csv

Código | Rubro | Concepto | Cantidad | Unidad | Moneda origen | Unitario origen | Unitario ARS referencia | Subtotal ARS sin previsión importación | Estado | Base y alcance | Fuentes | IDs CAD | Opcional | Tipo
M01 | Acero y chapas | Largueros RHS150×75×5 | 2 | barra 6m | ARS | 405060 | 405060 | 810120 | Estimado · a cotizar | 2 cortes×4400 mm. Estimación4000 ARS/kg sobre 202.53 kg de stock: medida especial sin precio publicado exacto. Compra barras completas; el sobrante queda en taller. Certificado, tolerancias y espesor real a confirmar. | Estimación propia | FR-LONG-I | FR-LONG-D | False | material
M02 | Acero y chapas | Travesaños RHS80×40×3 | 4 | barra 6m | ARS | 103599 | 103599 | 414396 | Estimado · a cotizar | 11 cortes×1850 mm; plan3+3+3+2. Precio proxy de 3.2 mm, no mismo espesor del CAD. Compra barras completas; el sobrante queda en taller. Certificado, tolerancias y espesor real a confirmar. | https://gramabi.com/productos/cano-estructural-rectangular-de-80-x-40-x-320-mm-gramabi-barra-de-6-mt-de-largo-tubo-80x40x325-medidas-hierro-80x40/ | FR-CROSS-01 | FR-CROSS-02 | FR-CROSS-03 | FR-CROSS-04 | FR-CROSS-05 | FR-CROSS-06 | FR-CROSS-07 | FR-CROSS-08 | FR-CROSS-09 | FR-CROSS-10 | FR-CROSS-11 | False | material
M03 | Acero y chapas | Brazos de lanza RHS150×60×5 | 1 | barra 6m | ARS | 376800 | 376800 | 376800 | Estimado · a cotizar | 2 cortes de 2706.67 mm aproximadamente;4000 ARS/kg sobre 94.2 kg de stock. Compra barras completas; el sobrante queda en taller. Certificado, tolerancias y espesor real a confirmar. | Estimación propia | DR-ARM--1 | DR-ARM-1 | False | material
M04 | Acero y chapas | Arriostramiento RHS60×40×3 | 1 | barra 6m | ARS | 85000 | 85000 | 85000 | Estimado · a cotizar | 1 corte928 mm antes del ajuste de extremos; estimación por sección, no precio directo. Compra barras completas; el sobrante queda en taller. Certificado, tolerancias y espesor real a confirmar. | https://gramabi.com/productos/cano-estructural-rectangular-de-80-x-40-x-320-mm-gramabi-barra-de-6-mt-de-largo-tubo-80x40x325-medidas-hierro-80x40/ | DR-BRACE | False | material
M05 | Acero y chapas | Reacción de estacionamiento RHS40×40×3 | 1 | barra 6m | ARS | 65000 | 65000 | 65000 | Estimado · a cotizar | 1 corte1850 mm; estimación por sección. Compra barras completas; el sobrante queda en taller. Certificado, tolerancias y espesor real a confirmar. | https://gramabi.com/productos/cano-estructural-rectangular-de-80-x-40-x-320-mm-gramabi-barra-de-6-mt-de-largo-tubo-80x40x325-medidas-hierro-80x40/ | FR-PARKCROSS | False | material
M06 | Acero y chapas | Travesaño posterior RHS80×60×3 | 1 | barra 6m | ARS | 106450,5 | 106450,5 | 106450,5 | Estimado · a cotizar | 1 corte2000 mm; proxy de 3.2 mm. Incluye solo BO-BUMPER; soportes van en chapas. Compra barras completas; el sobrante queda en taller. Certificado, tolerancias y espesor real a confirmar. | https://alumetalsa.com.ar/presupuestador/categoria-producto/canos-rectangulares/ | BO-BUMPER | False | material
M07 | Acero y chapas | Chapas mixtas e4/5/6/8/10 · soportes y puentes | 123 | kg bruto | ARS | 3200 | 3200 | 393600 | Estimado · a cotizar | 63 ítems CAD:90.64 kg geométricos netos×1.35, redondeo a kg.3200 ARS/kg incluye sobreprecio de fraccionado; corte/plegado se cobra en servicios. PuentesC75×40×4 se pliegan de chapa. No es peso de todo el chasis. | https://www.cormetal.com.ar/materiales-tiendacotizacion/rubro/8/materiales | Estimación propia | FR-DOUBLER--1-0 | FR-DOUBLER--1-1 | FR-DOUBLER--1-2 | FR-DOUBLER-1-0 | FR-DOUBLER-1-1 | FR-DOUBLER-1-2 | FR-BRACE--1-0 | FR-BRACE--1-1 | FR-BRACE-1-0 | FR-BRACE-1-1 | FR-BODYTAB-0 | FR-BODYTAB-1 | FR-BODYTAB-2 | FR-BODYTAB-3 | FR-BODYTAB-4 | FR-BODYTAB-5 | FR-BODYTAB-6 | FR-BODYTAB-7 | FR-BODYTAB-8 | FR-BODYTAB-9 | SU-HANGER--1-0 | SU-HANGER--1-1 | SU-HANGER--1-2 | SU-HANGER-1-0 | SU-HANGER-1-1 | SU-HANGER-1-2 | RU-TIEPLATE-0--1 | RU-TIEPLATE-0-1 | RU-TIEPLATE-1--1 | RU-TIEPLATE-1-1 | DR-TRANSFER--1 | DR-SIDEFISH--1 | DR-TRANSFER-1 | DR-SIDEFISH-1 | DR-NOSEPLATE | DR-CHAINANCHOR--1 | DR-CHAINANCHOR-1 | SU-BUMPBR--1-0 | SU-BUMPBR--1-1 | SU-BUMPBR-1-0 | SU-BUMPBR-1-1 | BO-FENDERBR--1-0 | BO-FENDERBR--1-1 | BO-FENDERBR--1-2 | BO-FENDERBR-1-0 | BO-FENDERBR-1-1 | BO-FENDERBR-1-2 | BO-BUMPERBR--1 | BO-BUMPERBR-1 | SU-DAMPERLOW-0--1 | SU-DAMPERUP-0--1 | SU-DAMPERLOW-0-1 | SU-DAMPERUP-0-1 | SU-DAMPERLOW-1--1 | SU-DAMPERUP-1--1 | SU-DAMPERLOW-1-1 | SU-DAMPERUP-1-1 | FR-HANGERBRIDGE-0 | FR-HANGERBRIDGE-1 | FR-HANGERBRIDGE-2 | EL-BOWDENANCHOR--1 | EL-BOWDENANCHOR-1 | DR-JOCKEYBRACE | False | material
M08 | Acero y chapas | Galvanizada2 mm · guardabarros y faldones | 1 | chapa 1.22×2.44m | ARS | 171026 | 171026 | 171026 | Publicado · confirmar anidado | 4 ítems CAD,21.12 kg geométricos netos; chapa bruta46.74 kg. Anidado/recortes a confirmar antes de corte; radios y desplegados todavía de desarrollo. | https://innoa.com.ar/categorias/pantografia/chapa-galvanizada/ | BO-FENDER--1 | BO-FENDERSKIRT--1 | BO-FENDER-1 | BO-FENDERSKIRT-1 | False | material
M09 | Rodado y frenos | Ejes frenados completos · referencia local1000 kg | 2 | eje | ARS | 1290000 | 1290000 | 2580000 | Publicado · configuración distinta | Incluye tubo, puntas, mazas/tambores, rodamientos, frenos y espárragos: se paga el conjunto una vez. Referencia4 agujeros distinta del CAD 5×114.3; requiere cotización a medida. | https://motustrailer.com.ar/product/eje-completo-con-frenos-electricos/ | RU-AXLETUBE-0 | RU-SPINDLE-0--1 | RU-BACKPLATE-0--1 | RU-SHOE-0--1-0 | RU-SHOE-0--1-1 | RU-MAGNET-0--1 | RU-DRUM-0--1 | RU-BEARINGS-0--1 | RU-STUDNUT-0--1-0 | RU-STUDNUT-0--1-1 | RU-STUDNUT-0--1-2 | RU-STUDNUT-0--1-3 | RU-STUDNUT-0--1-4 | RU-SPINDLE-0-1 | RU-BACKPLATE-0-1 | RU-SHOE-0-1-0 | RU-SHOE-0-1-1 | RU-MAGNET-0-1 | RU-DRUM-0-1 | RU-BEARINGS-0-1 | RU-STUDNUT-0-1-0 | RU-STUDNUT-0-1-1 | RU-STUDNUT-0-1-2 | RU-STUDNUT-0-1-3 | RU-STUDNUT-0-1-4 | RU-AXLETUBE-1 | RU-SPINDLE-1--1 | RU-BACKPLATE-1--1 | RU-SHOE-1--1-0 | RU-SHOE-1--1-1 | RU-MAGNET-1--1 | RU-DRUM-1--1 | RU-BEARINGS-1--1 | RU-STUDNUT-1--1-0 | RU-STUDNUT-1--1-1 | RU-STUDNUT-1--1-2 | RU-STUDNUT-1--1-3 | RU-STUDNUT-1--1-4 | RU-SPINDLE-1-1 | RU-BACKPLATE-1-1 | RU-SHOE-1-1-0 | RU-SHOE-1-1-1 | RU-MAGNET-1-1 | RU-DRUM-1-1 | RU-BEARINGS-1-1 | RU-STUDNUT-1-1-0 | RU-STUDNUT-1-1-1 | RU-STUDNUT-1-1-2 | RU-STUDNUT-1-1-3 | RU-STUDNUT-1-1-4 | False | material
M10 | Rodado y frenos | Configuración a medida y verificación de interfaces | 1 | previsión | ARS | 320000 | 320000 | 320000 | Estimado · a cotizar | Reserva para trocha/HF2260, centrosSC1925 y patrón5×114.3. No resuelve una incompatibilidad por sí sola; cotizar conjunto completo y reemplazar esta provisión con oferta firme. | Estimación propia | https://motustrailer.com.ar/product/eje-completo-con-frenos-electricos/ |  | False | material
M11 | Rodado y frenos | NeumáticoST205/75R15 107N D | 4 | unidad | USD | 186 | 288300 | 1153200 | Publicado · origen exterior | Goodyear Endurance como referencia que coincide con medida/índices del CAD. Precio origenEEUU; importación separada. | https://www.discounttire.com/buy-tires/goodyear-endurance/p/32602 | RU-TIRE-0--1 | RU-TIRE-0-1 | RU-TIRE-1--1 | RU-TIRE-1-1 | False | material
M12 | Rodado y frenos | Llantas15×5.5,5×114.3 con capacidad certificada | 4 | unidad | ARS | 150000 | 150000 | 600000 | Estimado · a cotizar | Estimación local, sin oferta exacta verificada. Confirmar ET, centro, asiento, presión y capacidad; no sustituir por llanta automotor usada sin validar. | Estimación propia | RU-RIM-0--1 | RU-RIM-0-1 | RU-RIM-1--1 | RU-RIM-1-1 | False | material
M13 | Suspensión | Paquetes completos doble ojo,1250 lb de referencia | 4 | paquete | USD | 34,18 | 52979,0 | 211916,0 | Publicado · referencia compatible a verificar | BOM de compra:4 paquetes completos. CAD actual:15 hojas representadas y4 pernos centrales; solo delantero izquierdo tiene3 hojas, los otros tres conservan4 pendientes de revisión. No comprar hojas sueltas. Cotejar forma libre/cargada. | https://trailerparts.com/3-leaf-1-250-lb-capacity-25-1-4-double-eye-trailer-leaf-spring-similar-to-una219-dexter-072-022-00.html | SU-LEAF--1-0-0 | SU-LEAF--1-0-1 | SU-LEAF--1-0-2 | SU-CENTERBOLT--1-0 | SU-LEAF--1-1-0 | SU-LEAF--1-1-1 | SU-LEAF--1-1-2 | SU-LEAF--1-1-3 | SU-CENTERBOLT--1-1 | SU-LEAF-1-0-0 | SU-LEAF-1-0-1 | SU-LEAF-1-0-2 | SU-LEAF-1-0-3 | SU-CENTERBOLT-1-0 | SU-LEAF-1-1-0 | SU-LEAF-1-1-1 | SU-LEAF-1-1-2 | SU-LEAF-1-1-3 | SU-CENTERBOLT-1-1 | False | material
M14 | Suspensión | Articulación tándem completa · húmedos y bronce | 1 | kit | USD | 160 | 248000 | 248000 | Estimado · a cotizar | EstimaciónUSD160 frente a kit estándarAP233 deUSD75.18. Incluye2 balancines,8 gemelas,14 pernos/tuercas,14 bujes y16 arandelas de empuje representadas. Configuración húmeda/bronce no cotizada; no sumar otro kit ni pernos sueltos. | https://www.etrailer.com/trailer-suspension/redline/ap233.html | Estimación propia | SU-PIN--1-0 | SU-PIN--1-0-NUT | SU-PIN--1-1 | SU-PIN--1-1-NUT | SU-PIN--1-2 | SU-PIN--1-2-NUT | SU-EQUALIZER--1 | SU-EQBUSH--1-0 | SU-EQBUSH--1-1 | SU-EQBUSH--1-2 | SU-BUSH--1-0-0 | SU-BUSH--1-0-1 | SU-SHACKLE--1-0--1 | SU-SHACKLE--1-0-1 | SU-INNERPIN--1-0 | SU-INNERPIN--1-0-NUT | SU-EQENDPIN--1-0 | SU-EQENDPIN--1-0-NUT | SU-BUSH--1-1-0 | SU-BUSH--1-1-1 | SU-SHACKLE--1-1--1 | SU-SHACKLE--1-1-1 | SU-INNERPIN--1-1 | SU-INNERPIN--1-1-NUT | SU-EQENDPIN--1-1 | SU-EQENDPIN--1-1-NUT | SU-PIN-1-0 | SU-PIN-1-0-NUT | SU-PIN-1-1 | SU-PIN-1-1-NUT | SU-PIN-1-2 | SU-PIN-1-2-NUT | SU-EQUALIZER-1 | SU-EQBUSH-1-0 | SU-EQBUSH-1-1 | SU-EQBUSH-1-2 | SU-BUSH-1-0-0 | SU-BUSH-1-0-1 | SU-SHACKLE-1-0--1 | SU-SHACKLE-1-0-1 | SU-INNERPIN-1-0 | SU-INNERPIN-1-0-NUT | SU-EQENDPIN-1-0 | SU-EQENDPIN-1-0-NUT | SU-BUSH-1-1-0 | SU-BUSH-1-1-1 | SU-SHACKLE-1-1--1 | SU-SHACKLE-1-1-1 | SU-INNERPIN-1-1 | SU-INNERPIN-1-1-NUT | SU-EQENDPIN-1-1 | SU-EQENDPIN-1-1-NUT | SU-THRUST--1-0-SPR--1 | SU-THRUST--1-0-SPR-1 | SU-THRUST--1-0-EQ--1 | SU-THRUST--1-0-EQ-1 | SU-THRUST--1-1-SPR--1 | SU-THRUST--1-1-SPR-1 | SU-THRUST--1-1-EQ--1 | SU-THRUST--1-1-EQ-1 | SU-THRUST-1-0-SPR--1 | SU-THRUST-1-0-SPR-1 | SU-THRUST-1-0-EQ--1 | SU-THRUST-1-0-EQ-1 | SU-THRUST-1-1-SPR--1 | SU-THRUST-1-1-SPR-1 | SU-THRUST-1-1-EQ--1 | SU-THRUST-1-1-EQ-1 | False | material
M15 | Suspensión | AbrazaderasU y tuercas/arandelas | 8 | juegoU+2tuercas | ARS | 18000 | 18000 | 144000 | Estimado · a cotizar | 8 abrazaderas con 16 tuercas/arandelas. Placas de apriete enM07, asientos enM16. Diámetro y kitOEM por cerrar; no fabricar abrazaderas con varilla roscada común. | Estimación propia | RU-UBOLT-0--1-0 | RU-UNUT-0--1-0--1 | RU-UNUT-0--1-0-1 | RU-UBOLT-0--1-1 | RU-UNUT-0--1-1--1 | RU-UNUT-0--1-1-1 | RU-UBOLT-0-1-0 | RU-UNUT-0-1-0--1 | RU-UNUT-0-1-0-1 | RU-UBOLT-0-1-1 | RU-UNUT-0-1-1--1 | RU-UNUT-0-1-1-1 | RU-UBOLT-1--1-0 | RU-UNUT-1--1-0--1 | RU-UNUT-1--1-0-1 | RU-UBOLT-1--1-1 | RU-UNUT-1--1-1--1 | RU-UNUT-1--1-1-1 | RU-UBOLT-1-1-0 | RU-UNUT-1-1-0--1 | RU-UNUT-1-1-0-1 | RU-UBOLT-1-1-1 | RU-UNUT-1-1-1--1 | RU-UNUT-1-1-1-1 | False | material
M16 | Suspensión | Asientos de ballesta mecanizados | 4 | unidad | ARS | 20000 | 20000 | 80000 | Estimado · a cotizar | Componente de compra a especificar paraØ60.325; incluye alojamiento de cabeza central. Material y mecanizado incluidos en esta estimación, no enM07. | Estimación propia | RU-SEAT-0--1 | RU-SEAT-0-1 | RU-SEAT-1--1 | RU-SEAT-1-1 | False | material
M17 | Suspensión | Amortiguador283271 con herrajes de espárrago | 4 | conjunto | USD | 65,95 | 102222,5 | 408890,0 | Publicado · origen exterior | 4 amortiguadores y4 conjuntos CAD de gomas/arandelas/tuercas en un único costo. Ménsulas propias enM07. Confirmar herrajes incluidos y curva con proveedor. | https://www.lippert.com/towing-trailering/wheel-axle/suspension-parts/shocks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 | https://www.southwestwheel.com/p-12330-lippert-standard-replacement-shock-black-283271.aspx | SU-DAMPER-0--1 | SU-DAMPER-0-1 | SU-DAMPER-1--1 | SU-DAMPER-1-1 | SU-DAMPERKIT-0--1 | SU-DAMPERKIT-0-1 | SU-DAMPERKIT-1--1 | SU-DAMPERKIT-1-1 | False | material
M18 | Suspensión | Topes elastoméricos de compresión | 4 | unidad | ARS | 18000 | 18000 | 72000 | Estimado · a cotizar | Solo goma/tope; soporte metálico enM07. Rigidez y altura a especificar. | Estimación propia | SU-BUMP--1-0 | SU-BUMP--1-1 | SU-BUMP-1-0 | SU-BUMP-1-1 | False | material
M19 | Lanza y apoyos | Cabezal50 mm con pestillo y palanca ·614010PL | 1 | conjunto | AUD | 129 | 138962,27 | 138962,27 | Publicado · interfaz pendiente | ReferenciaAUD, palanca incluida. Dibujo de fijaciones de vendedor difiere del CAD: compatibilidad pendiente. No añadir otra palanca. | https://www.brisbanealko.com.au/products/al-ko-3500kg-50mm-fixed-coupling-with-brake-lever | DR-COUPLING | DR-LATCH | DR-PARKLEVER | False | material
M20 | Lanza y apoyos | Cadenas certificadas con grilletes/ganchos | 2 | conjunto | ARS | 65000 | 65000 | 130000 | Estimado · a cotizar | Previsión por conjunto certificado adecuado a masa remolcada; no inferir capacidad por diámetro del dibujo ni usar mosquetones decorativos. | Estimación propia | DR-CHAIN--1 | DR-CHAIN-1 | False | material
M21 | Lanza y apoyos | Jockey con rueda y abrazadera | 1 | conjunto | ARS | 143076 | 143076 | 143076 | Publicado · montaje a confirmar | Referencia1000 lb local; confirmarØ60 y recorrido. Adaptador propio enM07. | https://www.amato.com.ar/productos/rueda-timonera-reforzada-rebatible-y-regulable-para-trailer/ | DR-JOCKEYCLAMP | DR-JOCKEYTUBE | DR-JOCKEYWHEEL | False | material
M22 | Lanza y apoyos | Estabilizadores de esquina | 4 | unidad | ARS | 164904 | 164904 | 659616 | Publicado · modelo de referencia | Referencia local2000 lb; geometría final a confirmar. Son apoyos de estacionamiento, no reemplazan gatos de servicio ni elevan vehículo ocupado. | https://www.amato.com.ar/productos/pata-estabilizadora-trailer-con-gato-y-manivela-2000lbs/ | BO-STEADY--1-0 | BO-STEADY--1-1 | BO-STEADY-1-0 | BO-STEADY-1-1 | False | material
M23 | Fijaciones | Fijación de cabezalM12 8.8 | 4 | juego | ARS | 5000 | 5000 | 20000 | Estimado · a cotizar | Cada juego: bulón, tuerca y arandelas. Largo y cantidad final dependen de cabezal seleccionado. | Estimación propia | DR-BOLT--1462--27 | DR-BOLT--1462-27 | DR-BOLT--1278--27 | DR-BOLT--1278-27 | False | material
M24 | Fijaciones | Anclajes viviendaM10 con casquillo y contraplaca | 10 | conjunto | ARS | 12000 | 12000 | 120000 | Estimado · a cotizar | Kit completo listo para instalar: bulón8.8, casquillo, contraplaca e interfaz EPDM. OrejasFR-BODYTAB enM07; no incluye piso ni vivienda. | Estimación propia | BO-BODYMOUNT-0 | BO-BODYMOUNT-1 | BO-BODYMOUNT-2 | BO-BODYMOUNT-3 | BO-BODYMOUNT-4 | BO-BODYMOUNT-5 | BO-BODYMOUNT-6 | BO-BODYMOUNT-7 | BO-BODYMOUNT-8 | BO-BODYMOUNT-9 | False | material
M25 | Rodado y frenos | Estacionamiento: fundas, cables y repartidor | 1 | kit 4 ruedas | ARS | 225000 | 225000 | 225000 | Estimado · a cotizar | Previsión basada en kit publicado225000. Confirmar versión4 ruedas y terminales compatibles. Palanca ya incluida enM19; esta línea no agrega otra palanca al CAD. | https://motustrailer.com.ar/product/kit-de-freno-de-mano-para-trailers-con-cable-de-emergencia/ | Estimación propia | EL-PARKCABLE | False | material
M26 | Electricidad | Controlador de frenos · referencia económica | 1 | unidad | ARS | 420000 | 420000 | 420000 | Publicado · confirmar inclusión | No representado como pieza del chasis. La página de eje es contradictoria: presupuesto conservador separado. Si cotización confirma incluido, poner0 aquí. Confirmar respuesta de control y capacidad4 frenos. Cableado básico previsto enM32/S05; interfaces electrónicas especiales del tractor a cotizar. | https://motustrailer.com.ar/tienda-motus/ | https://motustrailer.com.ar/product/eje-completo-con-frenos-electricos/ |  | False | material
M27 | Electricidad | Ruptura eléctrica: interruptor, batería y caja | 1 | kit | ARS | 180000 | 180000 | 180000 | Estimado · a cotizar | Batería dedicada12V de capacidad por validar, interruptor/cable, caja estanca, fusible y cargador. No sustituye estacionamiento mecánico; confirmar duración de frenado. | Estimación propia | EL-BOX | EL-BREAKAWAY | False | material
M28 | Electricidad | Ópticas traseras LED con reversa | 1 | par | ARS | 37100 | 37100 | 37100 | Publicado · especificación a verificar | 2 unidades por juego; no multiplicar otra vez por 2. Marcado y distribución fotométrica a verificar. | https://www.innovaled.ar/productos-iluminacion-vehicular/faros-led | EL-TAILLAMP--1 | EL-TAILLAMP-1 | False | material
M29 | Electricidad | Marcadores laterales ámbar | 6 | unidad | ARS | 15000 | 15000 | 90000 | Estimado · a cotizar | Precio estimado por referencia lateral; seleccionar ámbar y soportes adecuados. | https://tdrepuestos.com.ar/tienda/3/ | Estimación propia | EL-SIDELAMP--1-0 | EL-SIDELAMP--1-1 | EL-SIDELAMP--1-2 | EL-SIDELAMP-1-0 | EL-SIDELAMP-1-1 | EL-SIDELAMP-1-2 | False | material
M30 | Electricidad | Catadióptricos triangulares rojos | 2 | unidad | ARS | 6500 | 6500 | 13000 | Estimado · a cotizar | Confirmar aprobación de producto, dimensiones y montaje. | Estimación propia | EL-REFLECTOR--1 | EL-REFLECTOR-1 | False | material
M31 | Electricidad | Portapatente e iluminación blanca | 1 | conjunto | ARS | 30000 | 30000 | 30000 | Estimado · a cotizar | Incluye soporte y luz; patente/trámite no incluidos. | Estimación propia | EL-PLATE | False | material
M32 | Electricidad | Mazo, conectores y protecciones | 1 | lote | ARS | 220000 | 220000 | 220000 | Estimado · a cotizar | Previsión:8m de cable7×1.5,20m de ramal2×2.5, corrugado, terminales sellados, fusibles y conector al tractor. Secciones/longitudes son previsiones de compra; cálculo de caída de tensión pendiente. | Estimación propia | EL-HARNESS | False | material
M33 | Electricidad | Presillas aisladas con fijación | 11 | juego | ARS | 3000 | 3000 | 33000 | Estimado · a cotizar | 11 posiciones CAD; cada juego incluye presilla y tornillo. Separado del cableadoM32. | Estimación propia | EL-CLIP-0 | EL-CLIP-1 | EL-CLIP-2 | EL-CLIP-3 | EL-CLIP-4 | EL-CLIP-5 | EL-CLIP-6 | EL-CLIP-7 | EL-CLIP-8 | EL-CLIP-9 | EL-CLIP-10 | False | material
M34 | Electricidad | Cajas de derivación estancas de frenos | 2 | unidad | ARS | 15000 | 15000 | 30000 | Estimado · a cotizar | Caja, prensaestopas y borneras incluidos. | Estimación propia | EL-JUNCTION-0 | EL-JUNCTION-1 | False | material
M35 | Fijaciones | Tornillería auxiliar no desglosada | 1 | lote | ARS | 85000 | 85000 | 85000 | Estimado · a cotizar | M8/M10 de ménsulas, fijaciones de ópticas, terminales mecánicos y remaches. Excluye kits ya contados enM15, M17, M23, M24, M33. | Estimación propia |  | False | material
C01 | Consumibles | AlambreMIG ER70S6 | 2 | rollo 5 kg | ARS | 29267 | 29267 | 58534 | Publicado · consumo estimado | Compra10 kg. Los11 ítemsCAD de cordones se cubren aquí; consumo real por WPS y cordones totales, no solo los dibujados. | https://dember.com.ar/producto/alambre-para-soldar-mig-er70s-6-0-8mm-rollo-5kg/ | FR-WELD-0 | FR-WELD-1 | FR-WELD-2 | FR-WELD-3 | FR-WELD-4 | FR-WELD-5 | FR-WELD-6 | FR-WELD-7 | FR-WELD-8 | FR-WELD-9 | FR-WELD-10 | False | consumable
C02 | Consumibles | Gas, abrasivos y consumibles de taller | 1 | lote | ARS | 150000 | 150000 | 150000 | Estimado · a cotizar | Previsión gas protector, discos corte/desbaste, brocas y limpieza. No incluye pintura ni alambreMIG ni mano de obra. | Estimación propia |  | False | consumable
S01 | Fabricación | Plantilla, trazado y preparación | 12 | hora | ARS | 18000 | 18000 | 216000 | Estimado · a cotizar | Tarifa de taller supuesta18000 ARS/h, costo final de planificación con herramientas/energía/gastos generales. No es salarioUOM ni oferta recibida. Excluye materiales, subcontratos y consumibles explícitos. | Estimación propia |  | False | service
S02 | Fabricación | Corte de tubos y perforado | 24 | hora | ARS | 18000 | 18000 | 432000 | Estimado · a cotizar | Tarifa de taller supuesta18000 ARS/h, costo final de planificación con herramientas/energía/gastos generales. No es salarioUOM ni oferta recibida. Excluye materiales, subcontratos y consumibles explícitos. | Estimación propia |  | False | service
S03 | Fabricación | Armado, punteo y soldadura | 56 | hora | ARS | 18000 | 18000 | 1008000 | Estimado · a cotizar | Tarifa de taller supuesta18000 ARS/h, costo final de planificación con herramientas/energía/gastos generales. No es salarioUOM ni oferta recibida. Excluye materiales, subcontratos y consumibles explícitos. | Estimación propia |  | False | service
S04 | Fabricación | Montaje mecánico de conjuntos | 24 | hora | ARS | 18000 | 18000 | 432000 | Estimado · a cotizar | Tarifa de taller supuesta18000 ARS/h, costo final de planificación con herramientas/energía/gastos generales. No es salarioUOM ni oferta recibida. Excluye materiales, subcontratos y consumibles explícitos. | Estimación propia |  | False | service
S05 | Fabricación | Instalación eléctrica | 14 | hora | ARS | 18000 | 18000 | 252000 | Estimado · a cotizar | Tarifa de taller supuesta18000 ARS/h, costo final de planificación con herramientas/energía/gastos generales. No es salarioUOM ni oferta recibida. Excluye materiales, subcontratos y consumibles explícitos. | Estimación propia |  | False | service
S06 | Fabricación | Reglaje frenos y estacionamiento | 12 | hora | ARS | 18000 | 18000 | 216000 | Estimado · a cotizar | Tarifa de taller supuesta18000 ARS/h, costo final de planificación con herramientas/energía/gastos generales. No es salarioUOM ni oferta recibida. Excluye materiales, subcontratos y consumibles explícitos. | Estimación propia |  | False | service
S07 | Fabricación | Control dimensional y terminación | 12 | hora | ARS | 18000 | 18000 | 216000 | Estimado · a cotizar | Tarifa de taller supuesta18000 ARS/h, costo final de planificación con herramientas/energía/gastos generales. No es salarioUOM ni oferta recibida. Excluye materiales, subcontratos y consumibles explícitos. | Estimación propia |  | False | service
S08 | Fabricación | Corte láser de chapas y preparación | 1 | lote | ARS | 280000 | 280000 | 280000 | Estimado · a cotizar | Subcontrato supuesto para el lote M07/M08; material ya contado. No duplica horas de corte de tubosS02. | Estimación propia |  | False | service
S09 | Fabricación | Plegado de puentes y guardabarros | 1 | lote | ARS | 180000 | 180000 | 180000 | Estimado · a cotizar | Previsión18 operaciones×10000 ARS. Desarrollos, radios y cantidad final por taller; material ya contado. | Estimación propia |  | False | service
S10 | Terminación | Preparación y sistema epoxi/poliuretano | 20 | m² estimado | ARS | 25000 | 25000 | 500000 | Estimado · a cotizar | Previsión de superficie exterior, no superficie total BREP que incluye interiores. Precio supuesto de servicio terminado con preparación/pinturas. No galvanizado en caliente; guardabarros galvanizados separados. | Estimación propia |  | False | service
S11 | Terminación | Protección de cavidades y sellados | 1 | lote | ARS | 80000 | 80000 | 80000 | Estimado · a cotizar | Aplicación de cera compatible y sellados locales; accesos y drenajes a definir. No asumir pintura interior integral de RHS. | Estimación propia |  | False | service
S12 | Logística | Fletes nacionales de materiales y conjuntos | 1 | previsiónAMBA | ARS | 300000 | 300000 | 300000 | Estimado · a cotizar | Taller y compras enAMBA, sin destino exacto. Incluye barras6m; no importaciones, que se calculan aparte. Fuera deAMBA recotizar. | Estimación propia |  | False | service
D01 | Desarrollo y ensayos | Ingeniería de detalle y cierre de interfaces | 60 | hora | ARS | 35000 | 35000 | 2100000 | Estimado · a cotizar | Previsión de revisión estructural/uniones, selecciónOEM y corrección de interferencias. No es trabajo ya ejecutado ni certificado de aptitud. | Estimación propia |  | False | development
D02 | Desarrollo y ensayos | Inspecciones, pesaje y ensayos de prototipo | 1 | provisión | ARS | 650000 | 650000 | 650000 | Estimado · a cotizar | Reserva para pesaje por rueda/enganche, inspección de soldaduras y pruebas de frenado. Protocolo/laboratorio por definir; no incluye aranceles oficiales ni garantiza aprobación. | Estimación propia |  | False | development
O01 | Auxilio opcional | Neumático de auxilioST205/75R15 | 1 | unidad | USD | 186 | 288300 | 288300 | Publicado · origen exterior | Adicional de compra no modelado; debe igualar selección final de rodado. | https://www.discounttire.com/buy-tires/goodyear-endurance/p/32602 |  | True | material
O02 | Auxilio opcional | Llanta de auxilio15×5.5,5×114.3 | 1 | unidad | ARS | 150000 | 150000 | 150000 | Estimado · a cotizar | Adicional no modelado; capacidad/ET/presión a confirmar. | Estimación propia |  | True | material
O03 | Auxilio opcional | Soporte de auxilio y fijación antiaflojamiento | 1 | conjunto | ARS | 120000 | 120000 | 120000 | Estimado · a cotizar | Provisión de soporte no diseñado enCAD; comprobar anclaje, acceso y masas antes de incorporar. | Estimación propia |  | True | material
Previsión importación |  |  |  |  |  |  |  | 2939121,92
Contingencia20% |  |  |  |  |  |  |  | 4276621,74
TOTAL base con desarrollo y auxilio |  |  |  |  |  |  |  | 25659730,43
