Felipe-klz/cr200-explorador/downloads/cr200.FCStd

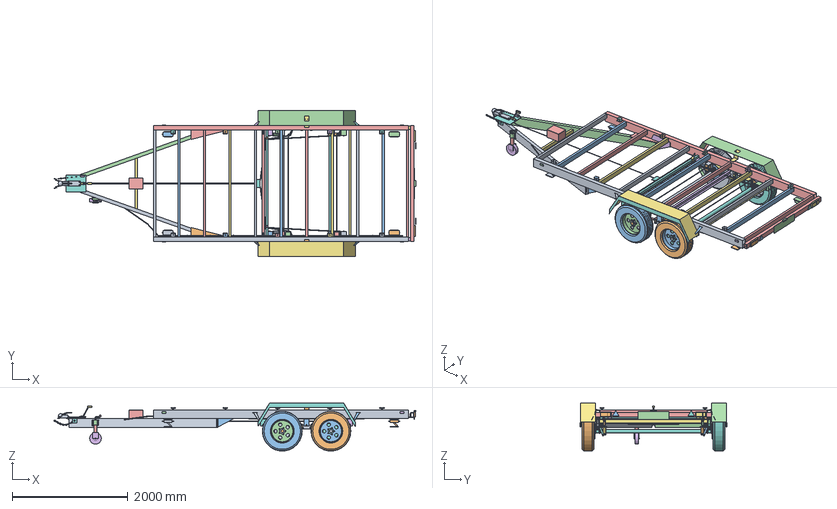
[picture p4: CAD file, 2026-10-24]
downloads/cr200.FCStd
6241.4 x 2520.0 x 826.5 mm
FR-LONG-I-1 · Larguero principal RHS150×75×5
FR-DOUBLER--1-0-1 · Placa de reparto e6 con extremos achaflanados
FR-DOUBLER--1-1-1 · Placa de reparto e6 con extremos achaflanados
FR-DOUBLER--1-2-1 · Placa de reparto e6 con extremos achaflanados
FR-LONG-D-1 · Larguero principal RHS150×75×5
FR-DOUBLER-1-0-1 · Placa de reparto e6 con extremos achaflanados
FR-DOUBLER-1-1-1 · Placa de reparto e6 con extremos achaflanados
FR-DOUBLER-1-2-1 · Placa de reparto e6 con extremos achaflanados
FR-CROSS-01-1 · Travesaño de piso80×40×3 · estación20
FR-WELD-0-1 · Cordones de unión travesaño1
FR-CROSS-02-1 · Travesaño de piso80×40×3 · estación440
FR-WELD-1-1 · Cordones de unión travesaño2
FR-CROSS-03-1 · Travesaño de piso80×40×3 · estación880
FR-WELD-2-1 · Cordones de unión travesaño3
FR-CROSS-04-1 · Travesaño de piso80×40×3 · estación1320
FR-WELD-3-1 · Cordones de unión travesaño4
FR-CROSS-05-1 · Travesaño de piso80×40×3 · estación1760
FR-WELD-4-1 · Cordones de unión travesaño5
FR-CROSS-06-1 · Travesaño de piso80×40×3 · estación2200
FR-WELD-5-1 · Cordones de unión travesaño6
FR-CROSS-07-1 · Travesaño de piso80×40×3 · estación2640
FR-WELD-6-1 · Cordones de unión travesaño7
FR-CROSS-08-1 · Travesaño de piso80×40×3 · estación3080
FR-WELD-7-1 · Cordones de unión travesaño8
FR-CROSS-09-1 · Travesaño de piso80×40×3 · estación3520
FR-WELD-8-1 · Cordones de unión travesaño9
FR-CROSS-10-1 · Travesaño de piso80×40×3 · estación3960
FR-WELD-9-1 · Cordones de unión travesaño10
FR-CROSS-11-1 · Travesaño de piso80×40×3 · estación4380
FR-WELD-10-1 · Cordones de unión travesaño11
FR-BRACE--1-0-1 · Cartela interior triangular del nudo de colgante
FR-BRACE--1-1-1 · Cartela interior triangular del nudo de colgante
FR-BRACE-1-0-1 · Cartela interior triangular del nudo de colgante
FR-BRACE-1-1-1 · Cartela interior triangular del nudo de colgante
FR-BODYTAB-0-1 · Oreja perforada de anclaje de vivienda M10
FR-BODYTAB-1-1 · Oreja perforada de anclaje de vivienda M10
FR-BODYTAB-2-1 · Oreja perforada de anclaje de vivienda M10
FR-BODYTAB-3-1 · Oreja perforada de anclaje de vivienda M10
FR-BODYTAB-4-1 · Oreja perforada de anclaje de vivienda M10
FR-BODYTAB-5-1 · Oreja perforada de anclaje de vivienda M10
FR-BODYTAB-6-1 · Oreja perforada de anclaje de vivienda M10
FR-BODYTAB-7-1 · Oreja perforada de anclaje de vivienda M10
FR-BODYTAB-8-1 · Oreja perforada de anclaje de vivienda M10
FR-BODYTAB-9-1 · Oreja perforada de anclaje de vivienda M10
FR-HANGERBRIDGE-0-1 · Puente transversal de colgantes · estación 1890.7
FR-HANGERBRIDGE-1-1 · Puente transversal de colgantes · estación 2640
FR-HANGERBRIDGE-2-1 · Puente transversal de colgantes · estación 3389.3
FR-PARKCROSS-1 · Travesaño auxiliar para reacción del estacionamiento
DR-ARM--1-1 · Brazo de lanzaA RHS150×60×5
DR-TRANSFER--1-1 · Placa horizontal de transferencia de lanza · e8
DR-SIDEFISH--1-1 · Cartela de transición de lanza · e6
DR-ARM-1-1 · Brazo de lanzaA RHS150×60×5
DR-TRANSFER-1-1 · Placa horizontal de transferencia de lanza · e8
DR-SIDEFISH-1-1 · Cartela de transición de lanza · e6
DR-BRACE-1 · Travesaño de arriostramiento de lanza60×40×3
DR-NOSEPLATE-1 · Placa mecanizada de cabezal ·350×300×10
DR-COUPLING-1 · Cabezal fijo50 mm · referencia614010PL
DR-LATCH-1 · Palanca y pestillo de seguridad del cabezal
DR-BOLT--1462--27-1 · Fijación de cabezalM12 clase8.8
DR-BOLT--1462-27-1 · Fijación de cabezalM12 clase8.8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
