Felipe-klz/cr200-explorador/(commit log)

2026-10-24 Publicar explorador CR200 con 302 sólidos interactivos y matriz normativa
    [cr200.FCStd]
2026-10-24 Organizar geometría, dependencias locales y descargas del explorador
    [cr200.FCStd]
2026-10-24 Preparar archivos de geometría y documentación CR200 R2
    [cr200.FCStd]
2026-10-24 Publicar CR200 R2: interfaces de chasis, 336 elementos y conocimiento trazable de Nav IA
    [cr200.FCStd]
2026-10-24 Preparar CAD y mediciones de auditoría S01
    [cr200.FCStd]
2026-10-24 Publicar S01: auditoría de amortiguación, geometría corregida y estado por subensamble
    [cr200.FCStd]
2026-10-24 Preparar activos S02-A: unión central de ballesta delantera izquierda
    [cr200.FCStd]
2026-10-24 Revisar unión central delantera izquierda y mostrar interferencias abiertas S02-A
    [cr200.FCStd]
2026-10-25 Preparar datos BOM y presupuesto Argentina ARS con fuentes
    [bom-335-elementos.csv, presupuesto-detallado.csv]
2026-10-25 Agregar BOM de335 elementos y presupuesto Argentina ARS con fuentes y escenarios
    [bom-335-elementos.csv, presupuesto-detallado.csv]
